jwcxz/CEREBRO/src/latex/code.pdf

## Appendix A: Cerebro Code, Main File, Joseph Colosimo

; vim : t s=4 sw=4 fdm=marker ;−−−−−−−−−−−−−−−−−−−−−−−−−−−−−−−−−−−−−−−−−−−−−−−−−−−−−−−−−−−−−−−−−−−−−−−−−−−−−−−

; C E R E B R O
; J . Colosimo
; 6. 1 1 5 Fi n al P r o j e c t ;
; CEREBRO
; main f i l e
;−−−−−−−−−−−−−−−−−−−−−−−−−−−−−−−−−−−−−−−−−−−−−−−−−−−−−−−−−−−−−−−−−−−−−−−−−−−−−−−

;−−−−−−−−−−−−−−−−−−−−−−−−−−−−−−−−−−−−−−−−−−−−−−−−−−−−−−−−−−−−−−−−−−−−−−−−−−−−−−−

; CONSTANTS
;−−−−−−−−−−−−−−−−−−−−−−−−−−−−−−−−−−−−−−−−−−−−−−−−−−−−−−−−−−−−−−−−−−−−−−−−−−−−−−−

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

+23=0x4F
Vm eeg thta equ Vm eeg dl ta+03d | ; | t h e t a
Vm ee g l alp equ Vm eeg dl ta+06d | ; | low alph a
Vm eeg halp equ Vm eeg dl ta+09d | ; | hi gh alph a
Vm ee g lbe t equ Vm eeg dl ta+012d | ; | low be t a
Vm eeg hbet equ Vm eeg dl ta+015d | ; | hi gh be t a
Vm eeg lgam equ Vm eeg dl ta+018d | ; | low gamma
Vm eeg mgam equ Vm eeg dl ta+021d | ; | mid gamma
Vm eeg csum got equ 070h | ; r e c e i v e d checksum ( f o r debugging )
Vm e e g a t t n l s t equ 07Dh | ; p r e vi o u s a t t e n t i o n v al u e
Vm eeg md tn ls t equ 07Eh | ; p r e vi o u s m e di t a ti o n v al u e

; e q u a l i z e r board c o n t ai n e r memory
Vm eqb vals equ 0B0h | ; 0xB0 −> 0xB7

; LED p a n el output b u f f e r ( used by F l p s e t p i x e l s )
Vm led r gb a r g s equ 071h | ; 0 x71 −> 0 x71+12=0x7C
Vm led rgba rg0 equ ( Vm led r gb a r g s ) | ; p i x e l 0
Vm led rgba rg1 equ ( Vm led r gb a r g s +3) | ; p i x e l 1
Vm led rgba rg2 equ ( Vm led r gb a r g s +6) | ; p i x e l 2
Vm led rgba rg3 equ ( Vm led r gb a r g s +9) | ; p i x e l 3

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

; ewma v al u e s
Vm ewma p0hue equ 0C0h
Vm ewma p0val equ ( Vm ewma p0hue+1) Vm ewma p1hue equ ( Vm ewma p0hue+2) Vm ewma p1val equ ( Vm ewma p0hue+3) Vm ewma p2hue equ ( Vm ewma p0hue+4) Vm ewma p2val equ ( Vm ewma p0hue+5) Vm ewma p3hue equ ( Vm ewma p0hue+6) Vm ewma p3val equ ( Vm ewma p0hue+7) ; }}}

o r g 00h
l jmp main

;−−−−−−−−−−−−−−−−−−−−−−−−−−−−−−−−−−−−−−−−−−−−−−−−−−−−−−−−−−−−−−−−−−−−−−−−−−−−−−−

; INTERRUPTS
;−−−−−−−−−−−−−−−−−−−−−−−−−−−−−−−−−−−−−−−−−−−−−−−−−−−−−−−−−−−−−−−−−−−−−−−−−−−−−−− 2

o r g 03h
l jmp F e c i n t

o r g 0Bh
l jmp F t h i n t

;−−−−−−−−−−−−−−−−−−−−−−−−−−−−−−−−−−−−−−−−−−−−−−−−−−−−−−−−−−−−−−−−−−−−−−−−−−−−−−−

; MAIN LOOP
;−−−−−−−−−−−−−−−−−−−−−−−−−−−−−−−−−−−−−−−−−−−−−−−−−−−−−−−−−−−−−−−−−−−−−−−−−−−−−−−

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

; s e t data ready o f f
mov R0 , #Vm eeg drdy
mov @R0, #00h

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

mov R0 , #Vm led rgbargsA
mov R1 , #012d
L m ai n i ni tA b u f :
mov @R0, #0h
i n c R0
d jnz R1 , L m ai n i ni tA b u f

mov R0 , #Vm led rgbargsB
mov R1 , #012d
L m ai n i ni tB b u f :
mov @R0, #0h
i n c R0
d jnz R1 , L m ai n i ni tB b u f

mov R0 , #Vm ewma p0hue
mov R1 , #08d
3

L main ini tewmabu f :
mov @R0, #0h
i n c R0
d jnz R1 , L main ini tewmabu f

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

; c o n v e r t the sec ond v al u e t o something between 1 and 4 f o r the ; t r a n s i t i o n speed
mov R0 , #Vm eqb vals+1
mov A, @R0
mov B, #064d
di v AB
i n c A | ; A r a n g e s from 1 − 4
i n c A | ; A r a n g e s from 2 − 5
i n c A | ; A r a n g e s from 3 − 6
mov @R0, A

; c o n v e r t the 3 rd v al u e t o something between 0 and f o r the al g o ; s e l e c t i o n
mov R0 , #Vm eqb vals+2
mov A, @R0
mov B, #064d
di v AB
mov @R0, A

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

mov R0 , #Vm eeg attn
mov A, @R0
mov R0 , #Vm e e g a t t n l s t mov @R0, A
4

mov R0 , #Vm eeg mdtn
mov A, @R0
mov R0 , #Vm eeg md tn ls t mov @R0, A
;−−−−−−

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

sjmp L m ain l o op

;−−−−−−−−−−−−−−−−−−−−−−−−−−−−−−−−−−−−−−−−−−−−−−−−−−−−−−−−−−−−−−−−−−−−−−−−−−−−−−−

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

mov A, #’ ’
l c a l l F s c t x

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

mov A, #’ ’
l c a l l F s c t x

mov R0 , #Vm eeg mdtn ; m e di t a ti o n mov A, @R0
l c a l l F s c p r t h e x

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

l c a l l F s c c r l f

5

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

r e t
; }}}

;−−−−−−−−−−−−−−−−−−−−−−−−−−−−−−−−−−−−−−−−−−−−−−−−−−−−−−−−−−−−−−−−−−−−−−−−−−−−−−−

; INCLUDES
;−−−−−−−−−−−−−−−−−−−−−−−−−−−−−−−−−−−−−−−−−−−−−−−−−−−−−−−−−−−−−−−−−−−−−−−−−−−−−−−

#i n cl u d e e e g c t r l . asm

#i n cl u d e eqboard . asm

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

6

## Appendix A: Cerebro Code, EEG Controller Library, Joseph Colosimo

; vim : t s=4 sw=4 fdm=marker ;−−−−−−−−−−−−−−−−−−−−−−−−−−−−−−−−−−−−−−−−−−−−−−−−−−−−−−−−−−−−−−−−−−−−−−−−−−−−−−−

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

;−−−−−−−−−−−−−−−−−−−−−−−−−−−−−−−−−−−−−−−−−−−−−−−−−−−−−−−−−−−−−−−−−−−−−−−−−−−−−−−

; NEEDED VALUES
;−−−−−−−−−−−−−−−−−−−−−−−−−−−−−−−−−−−−−−−−−−−−−−−−−−−−−−−−−−−−−−−−−−−−−−−−−−−−−−−

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

;−−−−−−−−−−−−−−−−−−−−−−−−−−−−−−−−−−−−−−−−−−−−−−−−−−−−−−−−−−−−−−−−−−−−−−−−−−−−−−−

; CONSTANTS
;−−−−−−−−−−−−−−−−−−−−−−−−−−−−−−−−−−−−−−−−−−−−−−−−−−−−−−−−−−−−−−−−−−−−−−−−−−−−−−−

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

V e c v al s y n c equ 0AAh

;−−−−−−−−−−−−−−−−−−−−−−−−−−−−−−−−−−−−−−−−−−−−−−−−−−−−−−−−−−−−−−−−−−−−−−−−−−−−−−−

; FUNCTIONS
;−−−−−−−−−−−−−−−−−−−−−−−−−−−−−−−−−−−−−−−−−−−−−−−−−−−−−−−−−−−−−−−−−−−−−−−−−−−−−−−
F e c i n t : | ; i n t e r r u p t h a n dl e r {{{ | 7

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

; s a ve A, B, and r e g i s t e r s {{{
push acc
push B
push DPH
push DPL
push 00h | ; R0
push 01h | ; R1
push 02h | ; R2
push 03h | ; R3
push 04h | ; R4
; }}}

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

mov R1 , #Vm eeg plen
mov A, @R1
mov R2 , A

mov R1 , #Vm eeg csum
mov A, @R1
mov R3 , A

mov R1 , #Vm eeg pptr
mov A, @R1
mov R4 , A
; }}}

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

mov A, R1 ; s a ve p acke t l e n g t h
add A, #01h
mov R2 , A

9

; new s t a t e −> payld
mov R0 , #V e c s t p a yl d

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

d jnz R2 , F e c i n t u s p a y l d s a v e

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

F e c i n t u s p a y l d s a v e :
mov B, R1 | ; B <− R1
mov A, R4
mov R1 , A | ; R1 = R4
mov @R1, B | ; s a ve c u r r e n t by te
mov R1 , B | ; R1 <− B
i n c R4 | ; inc remen t p oi n t e r
mov A, R3
add A, R1 | ; add t o checksum
mov R3 , A

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

; check t o s e e t h a t we have a v a l i d checksum
mov A, R3
c pl A
mov R3 , A ; s a ve checksum back

; FIXME: f o r debugging
; mov R3 , A ; s a ve checksum back ; mov R0 , #Vm eeg csum got
; mov B, R1
; mov @R0, B

; new s t a t e −> sync1
10 mov R0 , #V e c s t s y n c 1

; hack : u se R1 = 01h
c j n e A, 01h , F e c i n t u s c h k sm b a d

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

l jmp F e c i n t u s d o n e

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

l jmp F e c i n t u s d o n e

F e c i n t u s d o n e :

F e c i n t e n d :
; s e t memory v al u e s {{{ mov R1 , #Vm eeg smst
mov A, R0
mov @R1, A

mov R1 , #Vm eeg plen
mov A, R2
mov @R1, A

mov R1 , #Vm eeg csum
mov A, R3
mov @R1, A

mov R1 , #Vm eeg pptr
mov A, R4
mov @R1, A
; }}}

; r e s t o r e A, B, and r e g i s t e r s {{{ pop 04h ; R4
pop 03h ; R3
pop 02h ; R2
pop 01h ; R1
pop 00h ; R0
pop DPL
11

pop DPH
pop B
pop acc
; }}}

r e t i
; }}}

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

; s e t d i v i s o r
; 1. 8 4 2 e6 /16/9600 ˜= 12 mov A, #0Ch
mov DPTR, #V a e e g d l l movx @DPTR, A
mov A, #000h
mov DPTR, #Va eeg dlm
movx @DPTR, A

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

r e t
; }}}

F e c pl d : ; p r o c e s s payload {{{ ; −−− a c c o u n ti n g −−−
12

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

; s a ve A, B, and r e g i s t e r s {{{ push acc
push B
push 00h | ; R0
push 01h | ; R1
push 02h | ; R2
; }}}

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

F e c pl d d o n e :
; r e s t o r e A, B, and r e g i s t e r s {{{ pop 02h ; R2
pop 01h ; R1
pop 00h ; R0
pop B
13

pop acc
; }}}

r e t
; }}}

14

## Appendix A: Cerebro Code, Equalizer Board Library, Joseph Colosimo

; vim : t s=4 sw=4 fdm=marker ;−−−−−−−−−−−−−−−−−−−−−−−−−−−−−−−−−−−−−−−−−−−−−−−−−−−−−−−−−−−−−−−−−−−−−−−−−−−−−−−

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

;−−−−−−−−−−−−−−−−−−−−−−−−−−−−−−−−−−−−−−−−−−−−−−−−−−−−−−−−−−−−−−−−−−−−−−−−−−−−−−−

; NEEDED VALUES
;−−−−−−−−−−−−−−−−−−−−−−−−−−−−−−−−−−−−−−−−−−−−−−−−−−−−−−−−−−−−−−−−−−−−−−−−−−−−−−−

; Va eqb mux , Va eqb adc , Vm eqb val

;−−−−−−−−−−−−−−−−−−−−−−−−−−−−−−−−−−−−−−−−−−−−−−−−−−−−−−−−−−−−−−−−−−−−−−−−−−−−−−−

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

d jnz R1 , F e q s c a n l o o p

F e q s c a n d o n e :
; r e s t o r e A, B, and r e g i s t e r s {{{ pop 02h ; R2
pop 01h ; R1
pop 00h ; R0
pop DPL
pop DPH
pop B
pop acc
; }}}

r e t
; }}}

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

16

## Appendix A: Cerebro Code, Signal Processing Library, Joseph Colosimo

; vim : t s=4 sw=4 fdm=marker ;−−−−−−−−−−−−−−−−−−−−−−−−−−−−−−−−−−−−−−−−−−−−−−−−−−−−−−−−−−−−−−−−−−−−−−−−−−−−−−−

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

;−−−−−−−−−−−−−−−−−−−−−−−−−−−−−−−−−−−−−−−−−−−−−−−−−−−−−−−−−−−−−−−−−−−−−−−−−−−−−−−

; NEEDED VALUES
;−−−−−−−−−−−−−−−−−−−−−−−−−−−−−−−−−−−−−−−−−−−−−−−−−−−−−−−−−−−−−−−−−−−−−−−−−−−−−−−

; Vm eeg sgnl , Vm eeg dlta , Vm eeg attn , Vm eeg mdtn
; Vm led a r gbu f

;−−−−−−−−−−−−−−−−−−−−−−−−−−−−−−−−−−−−−−−−−−−−−−−−−−−−−−−−−−−−−−−−−−−−−−−−−−−−−−−

; CONSTANTS
;−−−−−−−−−−−−−−−−−−−−−−−−−−−−−−−−−−−−−−−−−−−−−−−−−−−−−−−−−−−−−−−−−−−−−−−−−−−−−−−

;−−−−−−−−−−−−−−−−−−−−−−−−−−−−−−−−−−−−−−−−−−−−−−−−−−−−−−−−−−−−−−−−−−−−−−−−−−−−−−−

; FUNCTIONS
;−−−−−−−−−−−−−−−−−−−−−−−−−−−−−−−−−−−−−−−−−−−−−−−−−−−−−−−−−−−−−−−−−−−−−−−−−−−−−−−

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

; s a ve A, B, and r e g i s t e r s {{{ push acc
push B
push 00h | ; R0
push 01h | ; R1
push 02h | ; R2
push 03h | ; R3
push 04h | ; R4 | 17

push 05h | ; R5
push 06h | ; R6
push 07h | ; R7
; }}}

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

mov R0 , #Vm eeg sgnl
mov A, @R0
j z F s p p r o c e s s s i g o k a y

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

F s p p r o c e s s d o n e :
; r e s t o r e A, B, and r e g i s t e r s {{{ pop 07h ; R7
pop 06h ; R6
pop 05h ; R5
pop 04h ; R4
pop 03h ; R3
pop 02h ; R2
pop 01h ; R1
pop 00h ; R0
pop B
pop acc
; }}}

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

; R1 : rgb p oi n t e r
; R2 : c o u n t e r

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

mov R0 , #Vm eeg sgnl
mov A, @R0
j z F s p si g b a d s e n s o k a y e n d
mov R0 , A

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

mov R0 , #Vm led a r gbu f
mov @R0, #030h
mov R0 , #Vm led a r gbu f+3 mov @R0, #030h
mov R0 , #Vm led a r gbu f+6 mov @R0, #030h
mov R0 , #Vm led a r gbu f+9 mov @R0, #030h
r e t

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

mov R2 , B ; temp
mov B, A
c l r C
mov A, #04d
subb A, B | ; 4 − q u o ti e n t g i v e s s i g n a l q u a l i t y low −> hi gh
mov R1 , A | ; temp

mov B, R2
mov A, #020d
c l r C
subb A, B ; 20 − rem ainde r g i v e s s i g q u a l i t y rem ainde r mov B, #04d
mul AB | ; s c a l e up
mov B, A | ; B has rem ainde r 0−>79
mov A, R1 | ; A has q u o ti e n t | 0−>4
| | 19

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

F s p si g o k a y d o n e :
r e t
; }}}

F s p al g o 1 : ; {{{
mov R0 , #Vm eeg sgnl
mov A, @R0
j n z F s p al g o 1 d o n e

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

mov A, R3
| 21

mov R0 , A | ; r e s t o r e R0
l c a l l F cu h s v 2 r gb | ; HSV −> RGB
mov A, R0
mov R3 , A | ; R3 <− R0

mov A, R3
mov R0 , #Vm led a r gbu f 0 mov @R0, A
mov R0 , #Vm led a r gbu f 1 mov @R0, A

mov A, R1
mov R0 , #Vm led a r gbu f 0+1 mov @R0, A
mov R0 , #Vm led a r gbu f 1+1 mov @R0, A

mov A, R2
mov R0 , #Vm led a r gbu f 0+2 mov @R0, A
mov R0 , #Vm led a r gbu f 1+2
mov @R0, A
;−−−−−−−−−−−−−−−−−−−−−−−−−−−−−−−−−−− }}}

; s e t m e di t a ti o n c o l o r {{{
; s e t m e di t a ti o n hue
; we want i t t o vary from cyan −> pu rple , which i s about 0+128−>85+128 mov B, #085d ; 120/360 x255 = 85
mov R0 , #Vm eeg mdtn
mov A, @R0
add A, #080h ; add
mov R3 , A
; s e t m e di t a ti o n s a t u r a t i o n mov R1 , #0FFh
; s e t m e di t a ti o n v al u e
mov R0 , #Vm eeg mdtn
mov A, @R0
mov R0 , #Vm eeg md tn ls t mov B, @R0
c l r C
subb A, B
jnb OV, F s p si g o k a y s ki pm d t n c pl c pl A
i n c A
F s p si g o k a y s ki pm d t n c pl :
mov B, #04d
mul AB
mov R2 , A

mov A, R3
mov R0 , A | ; r e s t o r e R0
l c a l l F cu h s v 2 r gb | ; HSV −> RGB
mov A, R0
mov R3 , A | ; R3 <− R0
22

mov A, R3
mov R0 , #Vm led a r gbu f 2 mov @R0, A
mov R0 , #Vm led a r gbu f 3 mov @R0, A

mov A, R1
mov R0 , #Vm led a r gbu f 2+1 mov @R0, A
mov R0 , #Vm led a r gbu f 3+1 mov @R0, A

mov A, R2
mov R0 , #Vm led a r gbu f 2+2 mov @R0, A
mov R0 , #Vm led a r gbu f 3+2
mov @R0, A
;−−−−−−−−−−−−−−−−−−−−−−−−−−−−−−−−−−− }}}

F s p al g o 1 d o n e :
r e t
; }}}

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

mov A, R0 ; s e t red
mov R0 , #Vm led a r gbu f 0 mov @R0, A
mov A, R1 ; s e t g r e en i n c R0
mov @R0, A
mov A, R2 ; s e t bl u e
i n c R0
mov @R0, A
; −−−

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

mov A, R0 ; s e t red
mov R0 , #Vm led a r gbu f 1 mov @R0, A
mov A, R1 ; s e t g r e en i n c R0
mov @R0, A
mov A, R2 ; s e t bl u e
i n c R0
mov @R0, A
; −−−

; p i x e l 2
mov R1 , #0FFh | ; f u l l s a t u r a t i o n
mov R0 , #Vm ee g lbe t+1 | ; 2nd by te o f low be t a
mov A, @R0
c l r C
r r c A
mov R2 , A
mov R0 , #0128d | ; bl u e
l c a l l F cu h s v 2 r gb

mov A, R0 ; s e t red
mov R0 , #Vm led a r gbu f 2 mov @R0, A
mov A, R1 ; s e t g r e en i n c R0
mov @R0, A
mov A, R2 ; s e t bl u e
i n c R0
mov @R0, A
; −−−

; p i x e l 3
mov R1 , #0FFh | ; f u l l s a t u r a t i o n
mov R0 , #Vm eeg lgam+1 | ; 2nd by te o f low gamma
mov A, @R0
c l r C
r r c A
mov R2 , A
mov R0 , #0196d | ; p u r pl e
l c a l l F cu h s v 2 r gb

mov A, R0 ; s e t red
mov R0 , #Vm led a r gbu f 3 mov @R0, A
mov A, R1 ; s e t g r e en i n c R0
mov @R0, A
mov A, R2 ; s e t bl u e
i n c R0
mov @R0, A
; −−−
24

F s p al g o 2 d o n e :
r e t
; }}}

F s p al g o 3 :
; p i x e l 0 {{{
; hue
mov R0 , #Vm eeg dl ta ; ! mov A, @R0
mov R1 , A
mov R0 , #Vm eeg thta+1 ; !
mov A, @R0
c l r C
subb A, R1 | ; l o w f r e q − hi g h f r e q
j c F s p al g o 3 p 0m o r el f t ; ! i f l o w f r e q > hi g h f r e q , s h i f t hue l e f t
F s p al g o 3 p 0m o r e r g t : | ; !
mov R7 , #042d | ; !
l jmp F s p al g o 3 p 0 h u e ; !
F s p al g o 3 p 0m o r el f t : | ; !
mov R7 , #0d | ; !
l jmp F s p al g o 3 p 0 h u e ; !
F s p al g o 3 p 0 h u e : | ; !
mov R1 , #Vm eqb vals+3
mov B, @R1 | ; B = ewma
mov A, #0FFh
c l r C
subb A, B | ; A = 1−ewma
mov R0 , #Vm ewma p0hue | ; !
mov B, @R0 | ; B = oldhue
mul AB
mov R3 , B | ; R3 = (1−ewma) ∗ oldhue
mov B, @R1 | ; B = ewma
mov A, R7 | ; R7 i s newhue
mul AB | ; B = (ewma) ∗newhue
mov A, R3
add A, B
mov R3 , A | ; R3 = ewma∗newhue + (1−ewma) ∗ oldhue

; v al u e
V s p al g o 3 p 0 v al : | ; !
mov R1 , #Vm eqb vals+4
mov B, @R1 | ; B = ewma
mov A, #0FFh
c l r C
subb A, B | ; A = 1−ewma
mov R0 , #Vm ewma p0val | ; !
mov B, @R0 | ; B = ol d v al
mul AB
25

mov R4 , B | ; R4 = (1−ewma) ∗ ol d v al
mov R0 , #Vm eeg dl ta | ; !
mov A, @R0
c l r C
r r c A
mov B, A
mov R0 , #Vm eeg thta+1 ; ! mov A, @R0
c l r C
r r c A
add A, B | ; A = newval ( a v e r a g e )
mov B, @R1 | ; B = ewma
mul AB
mov A, R4
add A, B
mov R4 , A | ; R4 = ewma∗newval + (1−ewma) ∗ ol d v al

; update ol d v al u e s
mov R0 , #Vm ewma p0hue | ; !
mov A, R3
mov @R0, A
mov R0 , #Vm ewma p0val | ; !
mov A, R4
mov @R0, A

; s e t e v e r y t hi n g mov A, R3
mov R0 , A
mov R1 , #0FFh
mov A, R4
mov R2 , A

l c a l l F cu h s v 2 r gb

mov A, R0 | ; s e t red
mov R0 , #Vm led a r gbu f 0 | ; !
mov @R0, A
mov A, R1 ; s e t g r e en
i n c R0
mov @R0, A
mov A, R2 ; s e t bl u e
i n c R0
mov @R0, A
; }}}

; p i x e l 1 {{{
; hue
mov R0 , #Vm ee g l alp+1 ; ! mov A, @R0
mov R1 , A
mov R0 , #Vm eeg halp+1 ; ! mov A, @R0
c l r C
26

subb A, R1 | ; l o w f r e q − hi g h f r e q
j c F s p al g o 3 p 1m o r el f t ; ! i f l o w f r e q > hi g h f r e q , s h i f t hue l e f t
F s p al g o 3 p 1m o r e r g t : | ; !
mov R7 , #084d | ; !
l jmp F s p al g o 3 p 1 h u e ; !
F s p al g o 3 p 1m o r el f t : | ; !
mov R7 , #042d | ; !
l jmp F s p al g o 3 p 1 h u e ; !
F s p al g o 3 p 1 h u e : | ; !
mov R1 , #Vm eqb vals+3
mov B, @R1 | ; B = ewma
mov A, #0FFh
c l r C
subb A, B | ; A = 1−ewma
mov R0 , #Vm ewma p1hue | ; !
mov B, @R0 | ; B = oldhue
mul AB
mov R3 , B | ; R3 = (1−ewma) ∗ oldhue
mov B, @R1 | ; B = ewma
mov A, R7 | ; R7 i s newhue
mul AB | ; B = (ewma) ∗newhue
mov A, R3
add A, B
mov R3 , A | ; R3 = ewma∗newhue + (1−ewma) ∗ oldhue

; v al u e
V s p al g o 3 p 1 v al : | ; !
mov R1 , #Vm eqb vals+5 | ; !
mov B, @R1 | ; B = ewma
mov A, #0FFh
c l r C
subb A, B | ; A = 1−ewma
mov R0 , #Vm ewma p1val | ; !
mov B, @R0 | ; B = ol d v al
mul AB
mov R4 , B | ; R4 = (1−ewma) ∗ ol d v al
mov R0 , #Vm ee g l alp+1 | ; !
mov A, @R0
c l r C
r r c A
mov B, A
mov R0 , #Vm eeg halp+1 ; ! mov A, @R0
c l r C
r r c A
add A, B | ; A = newval ( a v e r a g e )
mov B, @R1 | ; B = ewma
mul AB
mov A, R4
27

add A, B
mov R4 , A | ; R4 = ewma∗newval + (1−ewma) ∗ ol d v al

; update ol d v al u e s
mov R0 , #Vm ewma p1hue | ; !
mov A, R3
mov @R0, A
mov R0 , #Vm ewma p1val | ; !
mov A, R4
mov @R0, A

; s e t e v e r y t hi n g mov A, R3
mov R0 , A
mov R1 , #0FFh
mov A, R4
mov R2 , A

l c a l l F cu h s v 2 r gb

mov A, R0 | ; s e t red
mov R0 , #Vm led a r gbu f 1 | ; !
mov @R0, A
mov A, R1 ; s e t g r e en
i n c R0
mov @R0, A
mov A, R2 ; s e t bl u e
i n c R0
mov @R0, A
; }}}

; p i x e l 2 {{{
; hue
mov R0 , #Vm ee g lbe t+1 ; ! mov A, @R0
mov R1 , A
mov R0 , #Vm eeg hbet+1 ; !
mov A, @R0
c l r C
subb A, R1 | ; l o w f r e q − hi g h f r e q
j c F s p al g o 3 p 2m o r el f t ; ! i f l o w f r e q > hi g h f r e q , s h i f t hue l e f t
F s p al g o 3 p 2m o r e r g t : | ; !
mov R7 , #0126d | ; !
l jmp F s p al g o 3 p 2 h u e ; !
F s p al g o 3 p 2m o r el f t : | ; !
mov R7 , #084d | ; !
l jmp F s p al g o 3 p 2 h u e ; !
F s p al g o 3 p 2 h u e : | ; !
mov R1 , #Vm eqb vals+3
mov B, @R1 | ; B = ewma
mov A, #0FFh
c l r C
28

subb A, B | ; A = 1−ewma
mov R0 , #Vm ewma p2hue | ; !
mov B, @R0 | ; B = oldhue
mul AB
mov R3 , B | ; R3 = (1−ewma) ∗ oldhue
mov B, @R1 | ; B = ewma
mov A, R7 | ; R7 i s newhue
mul AB | ; B = (ewma) ∗newhue
mov A, R3
add A, B
mov R3 , A | ; R3 = ewma∗newhue + (1−ewma) ∗ oldhue

; v al u e
V s p al g o 3 p 2 v al : | ; !
mov R1 , #Vm eqb vals+6 | ; !
mov B, @R1 | ; B = ewma
mov A, #0FFh
c l r C
subb A, B | ; A = 1−ewma
mov R0 , #Vm ewma p2val | ; !
mov B, @R0 | ; B = ol d v al
mul AB
mov R4 , B | ; R4 = (1−ewma) ∗ ol d v al
mov R0 , #Vm ee g lbe t+1 | ; !
mov A, @R0
c l r C
r r c A
mov B, A
mov R0 , #Vm eeg hbet+1 ; ! mov A, @R0
c l r C
r r c A
add A, B | ; A = newval ( a v e r a g e )
mov B, @R1 | ; B = ewma
mul AB
mov A, R4
add A, B
mov R4 , A | ; R4 = ewma∗newval + (1−ewma) ∗ ol d v al

; update ol d v al u e s
mov R0 , #Vm ewma p2hue | ; !
mov A, R3
mov @R0, A
mov R0 , #Vm ewma p2val | ; !
mov A, R4
mov @R0, A

; s e t e v e r y t hi n g mov A, R3
mov R0 , A
mov R1 , #0FFh
29

mov A, R4
mov R2 , A

l c a l l F cu h s v 2 r gb

mov A, R0 | ; s e t red
mov R0 , #Vm led a r gbu f 2 | ; !
mov @R0, A
mov A, R1 ; s e t g r e en
i n c R0
mov @R0, A
mov A, R2 ; s e t bl u e
i n c R0
mov @R0, A
; }}}

; p i x e l 3 {{{
; hue
mov R0 , #Vm eeg lgam+1 ; ! mov @R0, A
mov R1 , A
mov R0 , #Vm eeg mgam+1 ; ! mov @R0, A
c l r C
r l c A
c l r C
subb A, R1 | ; l o w f r e q − hi g h f r e q
j c F s p al g o 3 p 3m o r el f t ; ! i f l o w f r e q > hi g h f r e q , s h i f t hue l e f t
F s p al g o 3 p 3m o r e r g t : | ; !
mov R7 , #0168d | ; !
l jmp F s p al g o 3 p 3 h u e ; !
F s p al g o 3 p 3m o r el f t : | ; !
mov R7 , #0126d | ; !
l jmp F s p al g o 3 p 3 h u e ; !
F s p al g o 3 p 3 h u e : | ; !
mov R1 , #Vm eqb vals+3
mov B, @R1 | ; B = ewma
mov A, #0FFh
c l r C
subb A, B | ; A = 1−ewma
mov R0 , #Vm ewma p3hue | ; !
mov B, @R0 | ; B = oldhue
mul AB
mov R3 , B | ; R3 = (1−ewma) ∗ oldhue
mov A, B
mov B, @R1 | ; B = ewma
mov A, R7 | ; R7 i s newhue
mul AB | ; B = (ewma) ∗newhue
mov A, R3
add A, B
30

mov R3 , A | ; R3 = ewma∗newhue + (1−ewma) ∗ oldhue

; v al u e
V s p al g o 3 p 3 v al : | ; !
mov R1 , #Vm eqb vals+7 | ; !
mov B, @R1 | ; B = ewma
mov A, #0FFh
c l r C
subb A, B | ; A = 1−ewma
mov R0 , #Vm ewma p3val | ; !
mov B, @R0 | ; B = ol d v al
mul AB
mov R4 , B | ; R4 = (1−ewma) ∗ ol d v al
mov R0 , #Vm eeg lgam+1 | ; !
mov A, @R0
c l r C
r r c A
mov B, A
mov R0 , #Vm eeg mgam+1 ; ! mov A, @R0
c l r C
r r c A
add A, B | ; A = newval ( a v e r a g e )
mov B, @R1 | ; B = ewma
mul AB
mov A, R4
add A, B
mov R4 , A | ; R4 = ewma∗newval + (1−ewma) ∗ ol d v al

; update ol d v al u e s
mov R0 , #Vm ewma p3hue | ; !
mov A, R3
mov @R0, A
mov R0 , #Vm ewma p3val | ; !
mov A, R4
mov @R0, A

; s e t e v e r y t hi n g mov A, R3
mov R0 , A
mov R1 , #0FFh
mov A, R4
mov R2 , A

l c a l l F cu h s v 2 r gb

mov A, R0 | ; s e t red
mov R0 , #Vm led a r gbu f 3 | ; !
mov @R0, A
mov A, R1 ; s e t g r e en
i n c R0
mov @R0, A
31

mov A, R2 ; s e t bl u e
i n c R0
mov @R0, A
; }}}

F s p al g o 3 d o n e :
r e t

32

## Appendix A: Cerebro Code, Transition Library, Joseph Colosimo

; vim : t s=4 sw=4 fdm=marker ;−−−−−−−−−−−−−−−−−−−−−−−−−−−−−−−−−−−−−−−−−−−−−−−−−−−−−−−−−−−−−−−−−−−−−−−−−−−−−−−

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

;−−−−−−−−−−−−−−−−−−−−−−−−−−−−−−−−−−−−−−−−−−−−−−−−−−−−−−−−−−−−−−−−−−−−−−−−−−−−−−−

; CONSTANTS
;−−−−−−−−−−−−−−−−−−−−−−−−−−−−−−−−−−−−−−−−−−−−−−−−−−−−−−−−−−−−−−−−−−−−−−−−−−−−−−−

;−−−−−−−−−−−−−−−−−−−−−−−−−−−−−−−−−−−−−−−−−−−−−−−−−−−−−−−−−−−−−−−−−−−−−−−−−−−−−−−

; FUNCTIONS
;−−−−−−−−−−−−−−−−−−−−−−−−−−−−−−−−−−−−−−−−−−−−−−−−−−−−−−−−−−−−−−−−−−−−−−−−−−−−−−−

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

; s a ve A, B, and r e g i s t e r s {{{ push acc
push B
push 00h | ; R0
push 01h | ; R1
push 02h | ; R2
; }}}

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

F t h c o p y s e tA :
mov @R0, #Vm led rgbargsA
l jmp F t h c o p y d o

F t h c o p y s e tB :
mov @R0, #Vm led rgbargsB
l jmp F t h c o p y d o

F t h c o p y d o :
mov A, @R0 | 33

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

F th c op y d one :
; r e s t o r e A, B, and r e g i s t e r s {{{ pop 02h ; R2
pop 01h ; R1
pop 00h ; R0
pop B
pop acc
; }}}

r e t
; }}}

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

; r e s e t c r o s s f a d e
mov R0 , #Vm led x fade
mov @R0, #0h

; e n a bl e tim e r
s e t b TR0

; r e s t o r e r e g i s t e r s {{{ pop 00h ; R0
; }}}

r e t
; }}}

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

; s a ve A, B, and r e g i s t e r s {{{ push acc
push B
34

push 00h | ; R0
push 01h | ; R1
push 02h | ; R2
push 03h | ; R3
push 04h | ; R4
push 05h | ; R5
push 06h | ; R6
; }}}

; g e t some v al u e s from memory mov R0 , #Vm led x fade
mov A, @R0
mov R3 , A

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

F t h i n t d o :
mov R2 , #Vm led r gb a r g s mov R4 , #012d
F t h i n t d o l o o p :
mov A, #0FFh
c l r C
subb A, R3
mov B, A | ; B = 255−x f a d e
mov A, @R0 | ; A = s t a r t v al u e
mul AB | ; A∗B
mov R5 , B | ; R5 h ol d s r e s u l t
mov A, @R1 | ; A = end v al u e
mov B, R3 | ; B = x f a d e
mul AB | ; A∗B
mov A, B | ; A h ol d s r e s u l t
add A, R5 | ; sum the two v al u e s
mov B, A | ; s t o r e t o B
mov A, R2 | ; A has output p oi n t e r
xch A, R0 | ; R0 now has output p oi n t e r
; A has s t a r t p oi n t e r
mov @R0, B | ; s t o r e output
xch A, R0 | ; A has output p oi n t e r
; R0 has s t a r t p oi n t e r mov R2 , A ; R2 has output p oi n t e r

35

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

d jnz R4 , F t h i n t d o l o o p

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

F t h i n t d o n e s k i p s t o p :
; r e s t o r e A, B, and r e g i s t e r s {{{
pop 06h ; R6
pop 05h ; R5
pop 04h ; R4
pop 03h ; R3
pop 02h ; R2
pop 01h ; R1
pop 00h ; R0
pop B
pop acc
; }}}

r e t i
; }}}

F t h i n i t t i m e r :
mov TMOD, #022h
mov TH0, #0128d
s e t b ET0
r e t

36

## Appendix A: Cerebro Code, LED Panel Controller Library, Joseph Colosimo

; vim : t s=4 sw=4 fdm=marker ;−−−−−−−−−−−−−−−−−−−−−−−−−−−−−−−−−−−−−−−−−−−−−−−−−−−−−−−−−−−−−−−−−−−−−−−−−−−−−−−

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

;−−−−−−−−−−−−−−−−−−−−−−−−−−−−−−−−−−−−−−−−−−−−−−−−−−−−−−−−−−−−−−−−−−−−−−−−−−−−−−−

; NEEDED VALUES
;−−−−−−−−−−−−−−−−−−−−−−−−−−−−−−−−−−−−−−−−−−−−−−−−−−−−−−−−−−−−−−−−−−−−−−−−−−−−−−−

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

;−−−−−−−−−−−−−−−−−−−−−−−−−−−−−−−−−−−−−−−−−−−−−−−−−−−−−−−−−−−−−−−−−−−−−−−−−−−−−−−

; CONSTANTS
;−−−−−−−−−−−−−−−−−−−−−−−−−−−−−−−−−−−−−−−−−−−−−−−−−−−−−−−−−−−−−−−−−−−−−−−−−−−−−−−

V l p l p i d equ 05h

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

;−−−−−−−−−−−−−−−−−−−−−−−−−−−−−−−−−−−−−−−−−−−−−−−−−−−−−−−−−−−−−−−−−−−−−−−−−−−−−−−

; FUNCTIONS
;−−−−−−−−−−−−−−−−−−−−−−−−−−−−−−−−−−−−−−−−−−−−−−−−−−−−−−−−−−−−−−−−−−−−−−−−−−−−−−−
F l p s e t w h ol e p a n el : | ; s e t a l l 4 p i x e l s t o same c o l o r {{{
; a r g s : R0 : red , R1 : grn , R2 : blu
; −−− a c c o u n ti n g −−− {{{
; R0 : red
; R1 : grn
; R2 : blu
; }}}

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

37

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

mov A, R0
l c a l l F l p s e n d b y t e | ; red

mov A, R1
l c a l l F l p s e n d b y t e | ; g re e n

mov A, R2
l c a l l F l p s e n d b y t e | ; bl u e

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

; s a ve A, B, and r e g i s t e r s {{{ push acc
push 00h | ; R0
push 01h | ; R1
push 02h | ; R2
; }}}

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

mov R1 , #Vm eqb vals
mov A, @R1
mov R1 , A

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

mov B, R1 ; apply g ai n c o r r e c t i o n mul AB
38

mov A, B

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

; s e t d i v i s o r
; 1. 8 4 3 2 e6 /16/38400 = 3 mov A, #03h
mov DPTR, #V a l e d d l l movx @DPTR, A
mov A, #000h
mov DPTR, #Va led dlm
movx @DPTR, A

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

pop acc
r e t
; }}}
F l p s e n d b y t e : | ; send a by te t o the LED Panel UART {{{
; a r g s : A: byte
; send by te t o 16C450
39

push 0h ; R0
push DPH
push DPL

mov DPTR, #V a l e d t h r movx @DPTR, A

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

pop DPL
pop DPH
pop 0h ; R0
r e t
; }}}

40

## Appendix A: Cerebro Code, Serial Communication Library, Joseph Colosimo

; vim : t s=4 sw=4 fdm=marker ;−−−−−−−−−−−−−−−−−−−−−−−−−−−−−−−−−−−−−−−−−−−−−−−−−−−−−−−−−−−−−−−−−−−−−−−−−−−−−−−

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

;−−−−−−−−−−−−−−−−−−−−−−−−−−−−−−−−−−−−−−−−−−−−−−−−−−−−−−−−−−−−−−−−−−−−−−−−−−−−−−−

; FUNCTIONS
;−−−−−−−−−−−−−−−−−−−−−−−−−−−−−−−−−−−−−−−−−−−−−−−−−−−−−−−−−−−−−−−−−−−−−−−−−−−−−−−
F s c i n i t s e r i a l : | ; i n i t i a l i z e s e r i a l communication {{{
mov TMOD, #020h | ; sw−c o n t r o l l e d gate , tim e r mode , 8−b i t a r time r 1
s e t b TR1
; mov | TH1, #0FFh | ; TH1 = 256 − 2 x11 . 0 5 9 2 e6 /384/57600 = 255 with PCON
on
; o r l | PCON, #080h | ; s e t PCON on
mov TH1, #0FDh
mov | SCON, #050h | ; e n a bl e 8−b i t UART, REN on

r e t
; }}}

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

42

## Appendix A: Cerebro Code, Color Utilities, Joseph Colosimo

; vim : t s=4 sw=4 fdm=marker ;−−−−−−−−−−−−−−−−−−−−−−−−−−−−−−−−−−−−−−−−−−−−−−−−−−−−−−−−−−−−−−−−−−−−−−−−−−−−−−−

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

;−−−−−−−−−−−−−−−−−−−−−−−−−−−−−−−−−−−−−−−−−−−−−−−−−−−−−−−−−−−−−−−−−−−−−−−−−−−−−−−

; CONSTANTS
;−−−−−−−−−−−−−−−−−−−−−−−−−−−−−−−−−−−−−−−−−−−−−−−−−−−−−−−−−−−−−−−−−−−−−−−−−−−−−−−

;−−−−−−−−−−−−−−−−−−−−−−−−−−−−−−−−−−−−−−−−−−−−−−−−−−−−−−−−−−−−−−−−−−−−−−−−−−−−−−−

; FUNCTIONS
;−−−−−−−−−−−−−−−−−−−−−−−−−−−−−−−−−−−−−−−−−−−−−−−−−−−−−−−−−−−−−−−−−−−−−−−−−−−−−−−

F cu h s v 2 r gb : ; c o n v e r t s hsv v al u e s i n t o rgb {{{
; a r g s : R0 : hue , R1 : s a t , R2 : v al
; out : R0 : red , R1 : grn , R2 : blu
; −−− a c c o u n ti n g −−− {{{
; R0 : hue −> red
; R1 : s a t −> grn
; R2 : v al −> blu
;
; R3 : h∗
; R4 : f
; R5 : p
; R6 : q
; R7 : t
; }}}

; s a ve A, B, and r e g i s t e r s {{{ push acc
push B
push 03h | ; R3
push 04h | ; R4
push 05h | ; R5
push 06h | ; R6
push 07h | ; R7
; }}}

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

; f i r s t , we want h∗ , the hex hue chunk o f a v al u e
; | 60 / ( 3 6 0 / 2 5 5 ) = 4 2. 5 , s o each hex a g on al hue chunk i s r o u g hl y sp aced
; | 4 2. 5 v a l s away . okay , s o that ’ s a b i t annoying , but we can make some
; | sp aced a t 42 and o t h e r s a t 43 a s f o l l o w s :
; | | | 42 | | | 43 | | | 42 | | | 43 | | | 42 | | | 43 | |
; | | | 0 | | | 1 | | | 2 | | | 3 | | | 4 | | | 5 | |
; | | | 0 : 4 1 | 4 2: 8 4 | 8 5 : 1 2 6 | 1 2 7 : 1 6 9 | 1 7 0 : 2 1 1 | 2 1 2 : 2 5 5 |

mov A, R0
mov B, #042d
di v AB

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

; nex t compute p = v ∗ ( 1 − s )
mov A, #0FFh
c l r C
subb A, R1 | ; A = 255 − s
mov B, R2 | ; B = v al
mul AB | ; p = v al ∗ ( 2 5 5 − s )
mov R5 , B | ; p = top byte ( r an ge s h i f t 256∗256 −> 2 5 6 )

; and q = v ∗ ( 1 − f ∗ s )
mov A, R4 | ; A = f
mov B, R1 | ; B = s
mul AB | ; compute f ∗ s | ( r an ge 0−>255∗41)
;−−−−−−−−−−−−− TODO: s u b r o u ti n e−i f y
; now we need a r an ge s h i f t from 0−>255∗41 t o 0−>255
; we do t h i s by m ul ti pl yi n g the v al u e by 255/42 = 6 and t a ki n g the top
| byte
push 00h ; R0
push 01h ; R1
mov R0 , B | ; s a ve hi gh by te o f m u l t i p l i c a t i o n
mov B, #06d
mul AB | ; m ul ti pl y low byte
44

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

pop 01h ; R1
pop 00h ; R0
;−−−−−−−−−−−−−
mov B, A | ; move q u o ti e n t t o B
mov A, #0FFh
c l r C
subb A, B | ; A = 255 − f ∗ s
mov B, R2 | ; B = v al
mul AB | ; q = v al ∗ ( 2 5 5 − f ∗ s )
mov R6 , B | ; q = top byte

; and f i n a l l y t = v ∗ ( 1 − ( 1 − f ) ∗ s ) mov A, #042d
c l r C
subb A, R4 | ; A = 42 − f
mov B, R1 | ; B = s a t
mul AB | ; AB = (42− f ) ∗ s
;−−−−−−−−−−−−− TODO: s u b r o u ti n e−i f y
; now we need a r an ge s h i f t from 0−>255∗41 t o 0−>255
; we do t h i s by m ul ti pl yi n g the v al u e by 255/42 = 6 and t a ki n g the top byte
push 00h ; R0
push 01h ; R1
mov R0 , B | ; s a ve hi gh by te o f m u l t i p l i c a t i o n
mov B, #06d
mul AB | ; m ul ti pl y low byte
mov R1 , B | ; we onl y c a r e about hi gh by te o f t h a t r e s u l t
mov A, R0
mov B, #06d
mul AB | ; m ul ti pl y p r e vi o u s hi gh byte by 6
add A, R1 | ; add low by te o f the r e s u l t t o the hi gh byte o f the
p r e vi o u s r e s u l t

pop 01h ; R1
pop 00h ; R0
;−−−−−−−−−−−−−
mov B, A | ; move q u o ti e n t t o B
mov A, #0FFh
c l r C
subb A, B | ; A = 255 − (42− f ) ∗ s
mov B, R2 | ; B = v al
mul AB | ; t = v al ∗ ( 2 5 5 − (42− f ) ∗ s )
mov R7 , B | ; t = top byte

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

c j n e R3 , #00h , F c u h s v 2 r g b h 1
mov A, R2 | ; v
mov R0 , A
mov A, R7 | ; t
mov R1 , A
mov A, R5 | ; p
mov R2 , A
l jmp F c u h s v 2 r g b e n d
F c u h s v 2 r g b h 1 : | ; rgb = qvp
c j n e R3 , #01h , F c u h s v 2 r g b h 2
mov A, R6 | ; q
mov R0 , A
mov A, R2 | ; v
mov R1 , A
mov A, R5 | ; p
mov R2 , A
l jmp F c u h s v 2 r g b e n d
F c u h s v 2 r g b h 2 : | ; rgb = pvt
c j n e R3 , #02h , F c u h s v 2 r g b h 3
mov A, R5 | ; p
mov R0 , A
mov A, R2 | ; v
mov R1 , A
mov A, R7 | ; t
mov R2 , A
l jmp F c u h s v 2 r g b e n d
F c u h s v 2 r g b h 3 : | ; rgb = pqv
c j n e R3 , #03h , F c u h s v 2 r g b h 4
mov A, R5 | ; p
mov R0 , A
mov A, R6 | ; q
mov R1 , A
mov A, R2 | ; v
mov R2 , A
l jmp F c u h s v 2 r g b e n d
F c u h s v 2 r g b h 4 : | ; rgb = tpv
c j n e R3 , #04h , F c u h s v 2 r g b h 5
mov A, R7 | ; t
mov R0 , A
mov A, R5 | ; p
mov R1 , A
mov A, R2 | ; v
mov R2 , A
l jmp F c u h s v 2 r g b e n d
F c u h s v 2 r g b h 5 : | ; rgb = vpq
mov A, R2 | ; v
mov R0 , A
mov A, R5 | ; p
mov R1 , A
46

mov A, R6 | ; q
mov R2 , A
l jmp F c u h s v 2 r g b e n d

F c u h s v 2 r g b e n d :
; r e s t o r e A, B, and r e g i s t e r s {{{
pop 07h | ; R7
pop 06h | ; R6
pop 05h | ; R5
pop 04h | ; R4
pop 03h | ; R3
pop B
pop acc
; }}}

r e t
; }}}

47

## Appendix A: Cerebro Code, EEG Data Capture Utility, Joseph Colosimo

;−−−−−−−−−−−−−−−−−−−−−−−−−−−−−−−−−−−−−−−−−−−−−−−−−−−−−−−−−−−−−−−−−−−−−−−−−−−−−−−

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

;−−−−−−−−−−−−−−−−−−−−−−−−−−−−−−−−−−−−−−−−−−−−−−−−−−−−−−−−−−−−−−−−−−−−−−−−−−−−−−−

; CONSTANTS
;−−−−−−−−−−−−−−−−−−−−−−−−−−−−−−−−−−−−−−−−−−−−−−−−−−−−−−−−−−−−−−−−−−−−−−−−−−−−−−−

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

;−−−−−−−−−−−−−−−−−−−−−−−−−−−−−−−−−−−−−−−−−−−−−−−−−−−−−−−−−−−−−−−−−−−−−−−−−−−−−−−

; INCLUDES
;−−−−−−−−−−−−−−−−−−−−−−−−−−−−−−−−−−−−−−−−−−−−−−−−−−−−−−−−−−−−−−−−−−−−−−−−−−−−−−−

o r g 00h
l jmp main

;−−−−−−−−−−−−−−−−−−−−−−−−−−−−−−−−−−−−−−−−−−−−−−−−−−−−−−−−−−−−−−−−−−−−−−−−−−−−−−−

; INTERRUPTS
;−−−−−−−−−−−−−−−−−−−−−−−−−−−−−−−−−−−−−−−−−−−−−−−−−−−−−−−−−−−−−−−−−−−−−−−−−−−−−−−

;−−−−−−−−−−−−−−−−−−−−−−−−−−−−−−−−−−−−−−−−−−−−−−−−−−−−−−−−−−−−−−−−−−−−−−−−−−−−−−−

; MAIN LOOP
;−−−−−−−−−−−−−−−−−−−−−−−−−−−−−−−−−−−−−−−−−−−−−−−−−−−−−−−−−−−−−−−−−−−−−−−−−−−−−−−

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

; t e s t
48

; Lloop :
; | mov A, #’T’
; | l c a l l F s e r t x
; | sjmp Lloop

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

sjmp L m ain l o op

;−−−−−−−−−−−−−−−−−−−−−−−−−−−−−−−−−−−−−−−−−−−−−−−−−−−−−−−−−−−−−−−−−−−−−−−−−−−−−−−

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

; s e t d i v i s o r
; 1. 8 4 2 e6 /16/9600 ˜= 12 mov A, #0Ch
mov DPTR, #V a d d r e e g dll movx @DPTR, A
mov A, #000h
mov DPTR, #V add r ee g dlm movx @DPTR, A

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

; s e t b EX0
; s e t b EA
49

r e t
; }}}
F i n i t s e r i a l : | ; i n i t i a l i z e s e r i a l communication {{{
mov TMOD, #020h | ; sw−c o n t r o l l e d gate , tim e r mode , 8−b i t a r time r 1
s e t b TR1
; mov | TH1, #0FFh | ; TH1 = 256 − 2 x11 . 0 5 9 2 e6 /384/57600 = 255 with PCON
on
; o r l | PCON, #080h | ; s e t PCON on
mov TH1, #0FDh
mov | SCON, #050h | ; e n a bl e 8−b i t UART, REN on

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

; −−− −−− −−−
; vim : e t t s=4 sw=4 fdm=marker

50

## Appendix A: Cerebro Code, Payload Test, Joseph Colosimo

; vim : t s=4 sw=4 fdm=marker ;−−−−−−−−−−−−−−−−−−−−−−−−−−−−−−−−−−−−−−−−−−−−−−−−−−−−−−−−−−−−−−−−−−−−−−−−−−−−−−−

; C E R E B R O
; J . Colosimo
; 6. 1 1 5 Fi n al P r o j e c t
;
; EEG Payload Capture Test
; Gets payload , d oe s b a si c p r o c e s si n g , p r i n t s t o s e r i a l ;−−−−−−−−−−−−−−−−−−−−−−−−−−−−−−−−−−−−−−−−−−−−−−−−−−−−−−−−−−−−−−−−−−−−−−−−−−−−−−−

;−−−−−−−−−−−−−−−−−−−−−−−−−−−−−−−−−−−−−−−−−−−−−−−−−−−−−−−−−−−−−−−−−−−−−−−−−−−−−−−

; CONSTANTS
;−−−−−−−−−−−−−−−−−−−−−−−−−−−−−−−−−−−−−−−−−−−−−−−−−−−−−−−−−−−−−−−−−−−−−−−−−−−−−−−

Va eeg equ 0FE00h
V a ee g r xb equ ( Va eeg + 00h ) | ; r e c e i v e r b u f f e r r e g ( dl ab = 0 )
V a e e g i e r equ ( Va eeg + 01h ) | ; i n t e r r u p t e n a bl e r e g ( dl ab = 0 )
V a e e g d l l equ ( Va eeg + 00h ) | ; d i v i s o r l a t c h ( l s b ) ( dl ab = 1 )
Va eeg dlm equ ( Va eeg + 01h ) | ; d i v i s o r l a t c h (msb ) ( dl ab = 1 )
V a e e g l c r equ ( Va eeg + 03h ) | ; l i n e c o n t r o l r e g
V a e e g l s r equ ( Va eeg + 05h ) | ; l i n e s t a t u s r e g
Vm eeg pptr d equ 050h | ; 0 x50 −> 0 x50+32=0x6F
Vm eeg smst | equ 030h
Vm eeg plen | equ 031h
Vm eeg pptr | equ 032h
Vm eeg csum | equ 033h
Vm eeg sgnl | equ 034h
Vm eeg dl ta | equ 038h | ; 0 x38 −> 0 x38+23=0x4F
Vm eeg attn | equ 035h
Vm eeg mdtn | equ 036h
Vm eeg drdy | equ 037h
Vm eeg csum got equ 072h
; Vm ee g ip t r | equ 070h
; Vm eeg optr | equ 071h

o r g 00h
l jmp main

;−−−−−−−−−−−−−−−−−−−−−−−−−−−−−−−−−−−−−−−−−−−−−−−−−−−−−−−−−−−−−−−−−−−−−−−−−−−−−−−

; INTERRUPTS
;−−−−−−−−−−−−−−−−−−−−−−−−−−−−−−−−−−−−−−−−−−−−−−−−−−−−−−−−−−−−−−−−−−−−−−−−−−−−−−−

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

; | push dph
; | push dpl
; | push 00h ; R0
;
; | mov R0 , #Vm ee g ip t r
; | mov A, @R0 | ; g e t i p t r
; | mov R0 , A | ; R0 <− i p t r
;
; | mov DPTR, #V a ee g r xb
; | movx A, @DPTR | ; g e t by te from s e r i a l
;
; | mov @R0, A | ; s t o r e byte t o @ip t r
;
; | i n c R0 | ; inc remen t p oi n t e r
; | c j n e R0 , #Vm eeg bu f+064d , IE0 end | ; i f we h i t the end o f the b u f f e r . . .
; | mov R0 , #Vm eeg bu f ; then wrap
;
; | IE0 end :
; | mov A, R0
; | mov R0 , #Vm ee g ip t r
; | mov @R0, A
; | pop 00h ; R0
; | pop dpl
; | pop dph
; | pop acc
;
; | r e t i

;−−−−−−−−−−−−−−−−−−−−−−−−−−−−−−−−−−−−−−−−−−−−−−−−−−−−−−−−−−−−−−−−−−−−−−−−−−−−−−−

; MAIN LOOP
;−−−−−−−−−−−−−−−−−−−−−−−−−−−−−−−−−−−−−−−−−−−−−−−−−−−−−−−−−−−−−−−−−−−−−−−−−−−−−−−

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

mov R0 , #Vm eeg drdy
mov @R0, #00h

L m ain l o op :
mov R0 , #Vm eeg drdy
mov A, @R0
j z L m ain l o op ; i s v al u e ready ?

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

mov A, #’ ’
l c a l l F s c t x

mov R0 , #Vm eeg mdtn ; m e di t a ti o n mov A, @R0
l c a l l F s c p r t h e x

mov A, #’ ’
l c a l l F s c t x

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

l c a l l F s c c r l f

; r e s e t drdy
mov R0 , #Vm eeg drdy
mov @R0, #00h

sjmp L m ain l o op

;−−−−−−−−−−−−−−−−−−−−−−−−−−−−−−−−−−−−−−−−−−−−−−−−−−−−−−−−−−−−−−−−−−−−−−−−−−−−−−−

; FUNCTIONS
;−−−−−−−−−−−−−−−−−−−−−−−−−−−−−−−−−−−−−−−−−−−−−−−−−−−−−−−−−−−−−−−−−−−−−−−−−−−−−−−

;−−−−−−−−−−−−−−−−−−−−−−−−−−−−−−−−−−−−−−−−−−−−−−−−−−−−−−−−−−−−−−−−−−−−−−−−−−−−−−−

; INCLUDES
;−−−−−−−−−−−−−−−−−−−−−−−−−−−−−−−−−−−−−−−−−−−−−−−−−−−−−−−−−−−−−−−−−−−−−−−−−−−−−−−

#i n cl u d e e e g c t r l . asm

#i n cl u d e sercom . asm

53

## Appendix A: Cerebro Code, LED Panel Test 1, Joseph Colosimo

; vim : t s=4 sw=4 fdm=marker ;−−−−−−−−−−−−−−−−−−−−−−−−−−−−−−−−−−−−−−−−−−−−−−−−−−−−−−−−−−−−−−−−−−−−−−−−−−−−−−−

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

;−−−−−−−−−−−−−−−−−−−−−−−−−−−−−−−−−−−−−−−−−−−−−−−−−−−−−−−−−−−−−−−−−−−−−−−−−−−−−−−

; CONSTANTS
;−−−−−−−−−−−−−−−−−−−−−−−−−−−−−−−−−−−−−−−−−−−−−−−−−−−−−−−−−−−−−−−−−−−−−−−−−−−−−−−

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

;−−−−−−−−−−−−−−−−−−−−−−−−−−−−−−−−−−−−−−−−−−−−−−−−−−−−−−−−−−−−−−−−−−−−−−−−−−−−−−−

; INCLUDES
;−−−−−−−−−−−−−−−−−−−−−−−−−−−−−−−−−−−−−−−−−−−−−−−−−−−−−−−−−−−−−−−−−−−−−−−−−−−−−−−

o r g 00h
l jmp main

;−−−−−−−−−−−−−−−−−−−−−−−−−−−−−−−−−−−−−−−−−−−−−−−−−−−−−−−−−−−−−−−−−−−−−−−−−−−−−−−

; INTERRUPTS
;−−−−−−−−−−−−−−−−−−−−−−−−−−−−−−−−−−−−−−−−−−−−−−−−−−−−−−−−−−−−−−−−−−−−−−−−−−−−−−−

;−−−−−−−−−−−−−−−−−−−−−−−−−−−−−−−−−−−−−−−−−−−−−−−−−−−−−−−−−−−−−−−−−−−−−−−−−−−−−−−

; MAIN LOOP
;−−−−−−−−−−−−−−−−−−−−−−−−−−−−−−−−−−−−−−−−−−−−−−−−−−−−−−−−−−−−−−−−−−−−−−−−−−−−−−−

o r g 0100h
main :
l c a l l F i n i t l e d

L m ain l o op :
mov DPTR, #V a d d r l e d t h r

54

mov A, #0aah
movx @DPTR, A

Lwait0 :
movx A, @DPTR
j n z A, Lwait0

mov A, #0252d
movx @DPTR, A

Lwait1 :
movx A, @DPTR
j n z A, Lwait1

mov A, #080d
movx @DPTR, A

Lwait2 :
movx A, @DPTR
j n z A, Lwait2

mov A, #010d
movx @DPTR, A

Lwait3 :
movx A, @DPTR
j n z A, Lwait3

mov A, #040d
movx @DPTR, A

mov R0 , #0h
mov R1 , #0h
LwaitA :
LwaitB :
; d jnz R0 , LwaitB
d jnz R1 , LwaitA

sjmp L m ain l o op

;−−−−−−−−−−−−−−−−−−−−−−−−−−−−−−−−−−−−−−−−−−−−−−−−−−−−−−−−−−−−−−−−−−−−−−−−−−−−−−−

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

55

; s e t d i v i s o r
; 1. 8 4 3 2 e6 /16/38400 = 3 mov A, #03h
mov DPTR, #V a d d r l e d d l l movx @DPTR, A
mov A, #000h
mov DPTR, #V add r led dlm movx @DPTR, A

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

r e t
; }}}

; −−− −−− −−−
; vim : e t t s=4 sw=4 fdm=marker

56

## Appendix A: Cerebro Code, LED Panel Test 2, Joseph Colosimo

; vim : t s=4 sw=4 fdm=marker ;−−−−−−−−−−−−−−−−−−−−−−−−−−−−−−−−−−−−−−−−−−−−−−−−−−−−−−−−−−−−−−−−−−−−−−−−−−−−−−−

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

;−−−−−−−−−−−−−−−−−−−−−−−−−−−−−−−−−−−−−−−−−−−−−−−−−−−−−−−−−−−−−−−−−−−−−−−−−−−−−−−

; CONSTANTS
;−−−−−−−−−−−−−−−−−−−−−−−−−−−−−−−−−−−−−−−−−−−−−−−−−−−−−−−−−−−−−−−−−−−−−−−−−−−−−−−

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

;−−−−−−−−−−−−−−−−−−−−−−−−−−−−−−−−−−−−−−−−−−−−−−−−−−−−−−−−−−−−−−−−−−−−−−−−−−−−−−−

; INCLUDES
;−−−−−−−−−−−−−−−−−−−−−−−−−−−−−−−−−−−−−−−−−−−−−−−−−−−−−−−−−−−−−−−−−−−−−−−−−−−−−−−

o r g 00h
l jmp main

;−−−−−−−−−−−−−−−−−−−−−−−−−−−−−−−−−−−−−−−−−−−−−−−−−−−−−−−−−−−−−−−−−−−−−−−−−−−−−−−

; INTERRUPTS
;−−−−−−−−−−−−−−−−−−−−−−−−−−−−−−−−−−−−−−−−−−−−−−−−−−−−−−−−−−−−−−−−−−−−−−−−−−−−−−−

;−−−−−−−−−−−−−−−−−−−−−−−−−−−−−−−−−−−−−−−−−−−−−−−−−−−−−−−−−−−−−−−−−−−−−−−−−−−−−−−

; MAIN LOOP
;−−−−−−−−−−−−−−−−−−−−−−−−−−−−−−−−−−−−−−−−−−−−−−−−−−−−−−−−−−−−−−−−−−−−−−−−−−−−−−− 57

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

L m ain l o op :
mov DPTR, #V a d d r l e d t h r mov A, #’a ’
movx @DPTR, A

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

; pause
Lwait1 :
Lwait2 :
; d jnz R0 , Lwait2
d jnz R1 , Lwait1

sjmp L m ain l o op

;−−−−−−−−−−−−−−−−−−−−−−−−−−−−−−−−−−−−−−−−−−−−−−−−−−−−−−−−−−−−−−−−−−−−−−−−−−−−−−−

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

; s e t d i v i s o r
; 2 e6 /16/38400 ˜= 3 , but with a 7% e r r o r r a t e −− maybe t o o hi gh ; mov A, #03h
mov A, #03h
mov DPTR, #V a d d r l e d d l l
movx @DPTR, A
mov A, #000h
mov DPTR, #V add r led dlm movx @DPTR, A

58

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

; s e t d i v i s o r
; 2 e6 /16/9600 ˜= 13
mov A, #03h
mov DPTR, #V a d d r e e g dll movx @DPTR, A
mov A, #000h
mov DPTR, #V add r ee g dlm movx @DPTR, A

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

; s e t b EX0
; s e t b EA

r e t
; }}}
F i n i t s e r i a l : | ; i n i t i a l i z e s e r i a l communication {{{
mov TMOD, #020h | ; sw−c o n t r o l l e d gate , tim e r mode , 8−b i t a r time r 1
s e t b TR1
; mov | TH1, #0FFh | ; TH1 = 256 − 2 x11 . 0 5 9 2 e6 /384/57600 = 255 with PCON
on
| | 59

; o r l | PCON, #080h | ; s e t PCON on
mov TH1, #0FDh
mov | SCON, #050h | ; e n a bl e 8−b i t UART, REN on

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

; −−− −−− −−−
; vim : e t t s=4 sw=4 fdm=marker

60

## Appendix A: Cerebro Code, LED Panel Test 3, Joseph Colosimo

; vim : t s=4 sw=4 fdm=marker ;−−−−−−−−−−−−−−−−−−−−−−−−−−−−−−−−−−−−−−−−−−−−−−−−−−−−−−−−−−−−−−−−−−−−−−−−−−−−−−−

; C E R E B R O
; J . Colosimo
; 6. 1 1 5 Fi n al P r o j e c t
;
; LED Panel C ol o r S h i f t i n g Test
; shows a hue s h i f t i n g output on the LED p a n el ;−−−−−−−−−−−−−−−−−−−−−−−−−−−−−−−−−−−−−−−−−−−−−−−−−−−−−−−−−−−−−−−−−−−−−−−−−−−−−−−

;−−−−−−−−−−−−−−−−−−−−−−−−−−−−−−−−−−−−−−−−−−−−−−−−−−−−−−−−−−−−−−−−−−−−−−−−−−−−−−−

; CONSTANTS
;−−−−−−−−−−−−−−−−−−−−−−−−−−−−−−−−−−−−−−−−−−−−−−−−−−−−−−−−−−−−−−−−−−−−−−−−−−−−−−−

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

o r g 00h
l jmp main

;−−−−−−−−−−−−−−−−−−−−−−−−−−−−−−−−−−−−−−−−−−−−−−−−−−−−−−−−−−−−−−−−−−−−−−−−−−−−−−−

; INTERRUPTS
;−−−−−−−−−−−−−−−−−−−−−−−−−−−−−−−−−−−−−−−−−−−−−−−−−−−−−−−−−−−−−−−−−−−−−−−−−−−−−−−

;−−−−−−−−−−−−−−−−−−−−−−−−−−−−−−−−−−−−−−−−−−−−−−−−−−−−−−−−−−−−−−−−−−−−−−−−−−−−−−−

; MAIN LOOP
;−−−−−−−−−−−−−−−−−−−−−−−−−−−−−−−−−−−−−−−−−−−−−−−−−−−−−−−−−−−−−−−−−−−−−−−−−−−−−−−

o r g 0100h
main :
l c a l l F l p i n i t l e d

mov R3 , #020h
mov R4 , #0FFh
mov R5 , #030h

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

61

; mov A, #0252d
; l c a l l F l p s e n d b y t e

; mov A, #080d
; l c a l l F l p s e n d b y t e

; mov A, #010d
; l c a l l F l p s e n d b y t e

; mov A, #040d
; l c a l l F l p s e n d b y t e ; }}}

mov A, R3
mov R0 , A

mov A, R4
mov R1 , A

mov A, R5
mov R2 , A

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

; mov A, R3
; add A, #05h
; mov R3 , A
i n c R3

; −− pause and l o o p −−
mov R6 , #0h
mov R7 , #0h
LwaitA :
LwaitB :
; d jnz R6 , LwaitB
d jnz R7 , LwaitA

l jmp L m ain l o op

;−−−−−−−−−−−−−−−−−−−−−−−−−−−−−−−−−−−−−−−−−−−−−−−−−−−−−−−−−−−−−−−−−−−−−−−−−−−−−−−

; FUNCTIONS
;−−−−−−−−−−−−−−−−−−−−−−−−−−−−−−−−−−−−−−−−−−−−−−−−−−−−−−−−−−−−−−−−−−−−−−−−−−−−−−−

;−−−−−−−−−−−−−−−−−−−−−−−−−−−−−−−−−−−−−−−−−−−−−−−−−−−−−−−−−−−−−−−−−−−−−−−−−−−−−−−

; INCLUDES
;−−−−−−−−−−−−−−−−−−−−−−−−−−−−−−−−−−−−−−−−−−−−−−−−−−−−−−−−−−−−−−−−−−−−−−−−−−−−−−−

#i n cl u d e c o l u t i l s . asm

#i n cl u d e l e d p a n el . asm

62

; −−− −−− −−−
; vim : e t t s=4 sw=4 fdm=marker

63

## Appendix A: Cerebro Code, Equalizer Board Test, Joseph Colosimo

; vim : t s=4 sw=4 fdm=marker ;−−−−−−−−−−−−−−−−−−−−−−−−−−−−−−−−−−−−−−−−−−−−−−−−−−−−−−−−−−−−−−−−−−−−−−−−−−−−−−−

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

;−−−−−−−−−−−−−−−−−−−−−−−−−−−−−−−−−−−−−−−−−−−−−−−−−−−−−−−−−−−−−−−−−−−−−−−−−−−−−−−

; CONSTANTS
;−−−−−−−−−−−−−−−−−−−−−−−−−−−−−−−−−−−−−−−−−−−−−−−−−−−−−−−−−−−−−−−−−−−−−−−−−−−−−−−

Va eqb mux equ P1
Va eqb adc equ 0FE10h

o r g 00h
l jmp main

;−−−−−−−−−−−−−−−−−−−−−−−−−−−−−−−−−−−−−−−−−−−−−−−−−−−−−−−−−−−−−−−−−−−−−−−−−−−−−−−

; MAIN LOOP
;−−−−−−−−−−−−−−−−−−−−−−−−−−−−−−−−−−−−−−−−−−−−−−−−−−−−−−−−−−−−−−−−−−−−−−−−−−−−−−−

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

l c a l l F s c p r t h e x

mov A, #’ ’
l c a l l F s c t x

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

l c a l l F s c c r l f
mov R0 , #0d
L w ai t : d jnz R0 , L w ai t mov R0 , #0d
L w ai t 2 : d jnz R0 , L w ai t 2
sjmp L m ain l o op

;−−−−−−−−−−−−−−−−−−−−−−−−−−−−−−−−−−−−−−−−−−−−−−−−−−−−−−−−−−−−−−−−−−−−−−−−−−−−−−−

; INCLUDES
;−−−−−−−−−−−−−−−−−−−−−−−−−−−−−−−−−−−−−−−−−−−−−−−−−−−−−−−−−−−−−−−−−−−−−−−−−−−−−−−

#i n cl u d e sercom . asm

65
