jwcxz/CEREBRO/proposal/fig/blockdiagram.pdf

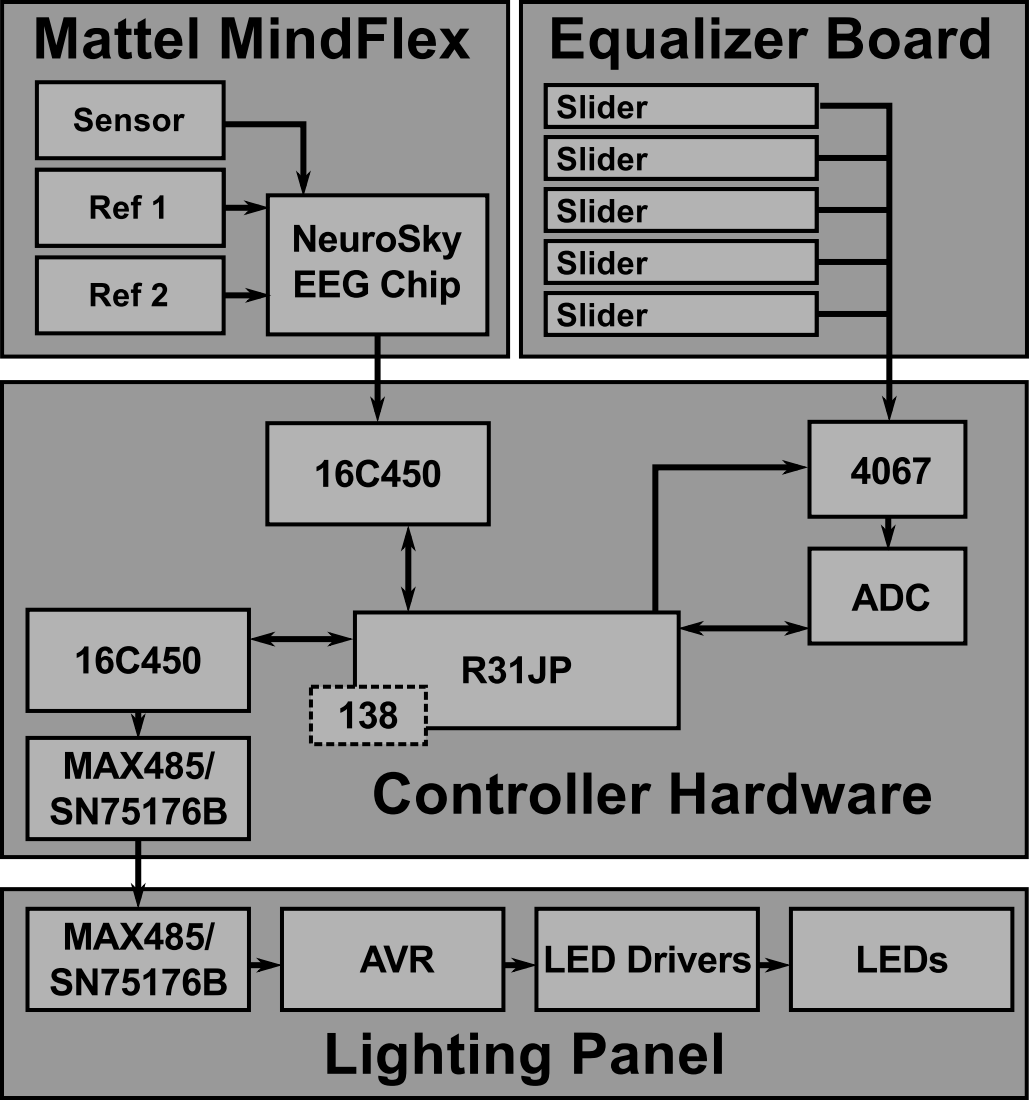
[picture p11: page 1]
