jwcxz/CEREBRO/proposal/fig/drawing.pdf

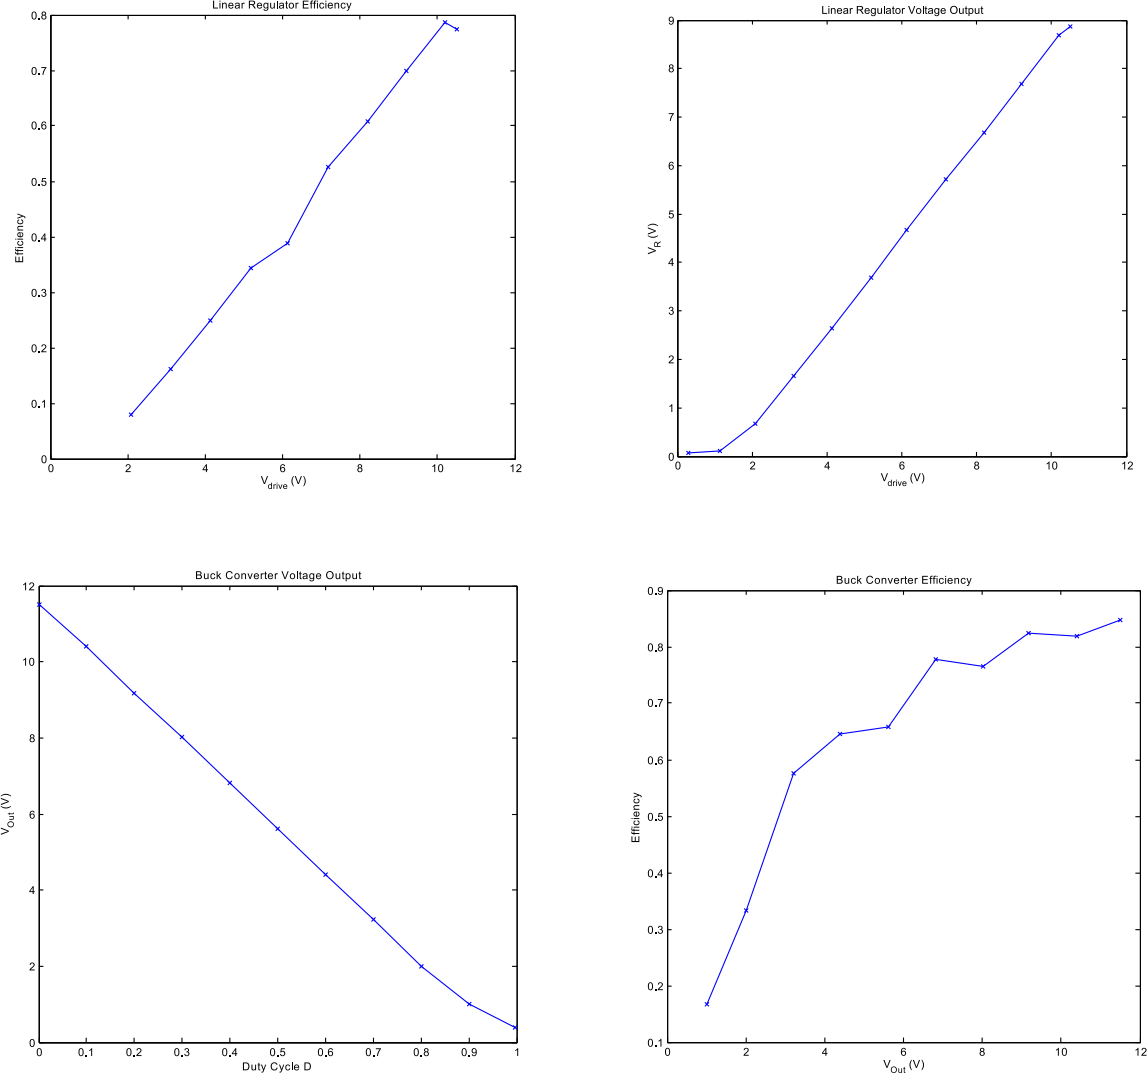
[picture p13: page 1]
