jwcxz/CEREBRO/proposal/fig/software.pdf

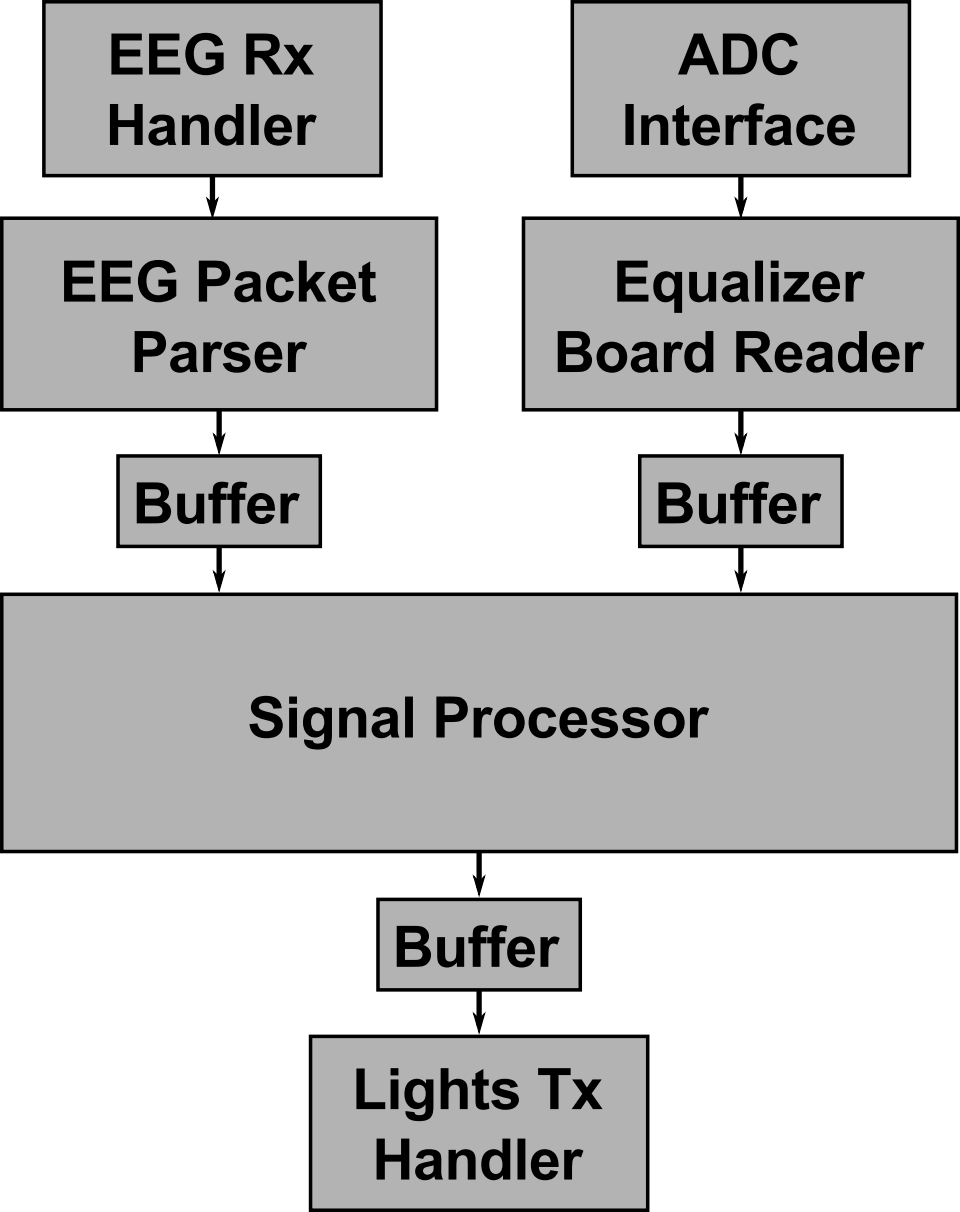
[picture p14: page 1]
