jwcxz/CEREBRO/report/fig/blockdiagram.pdf

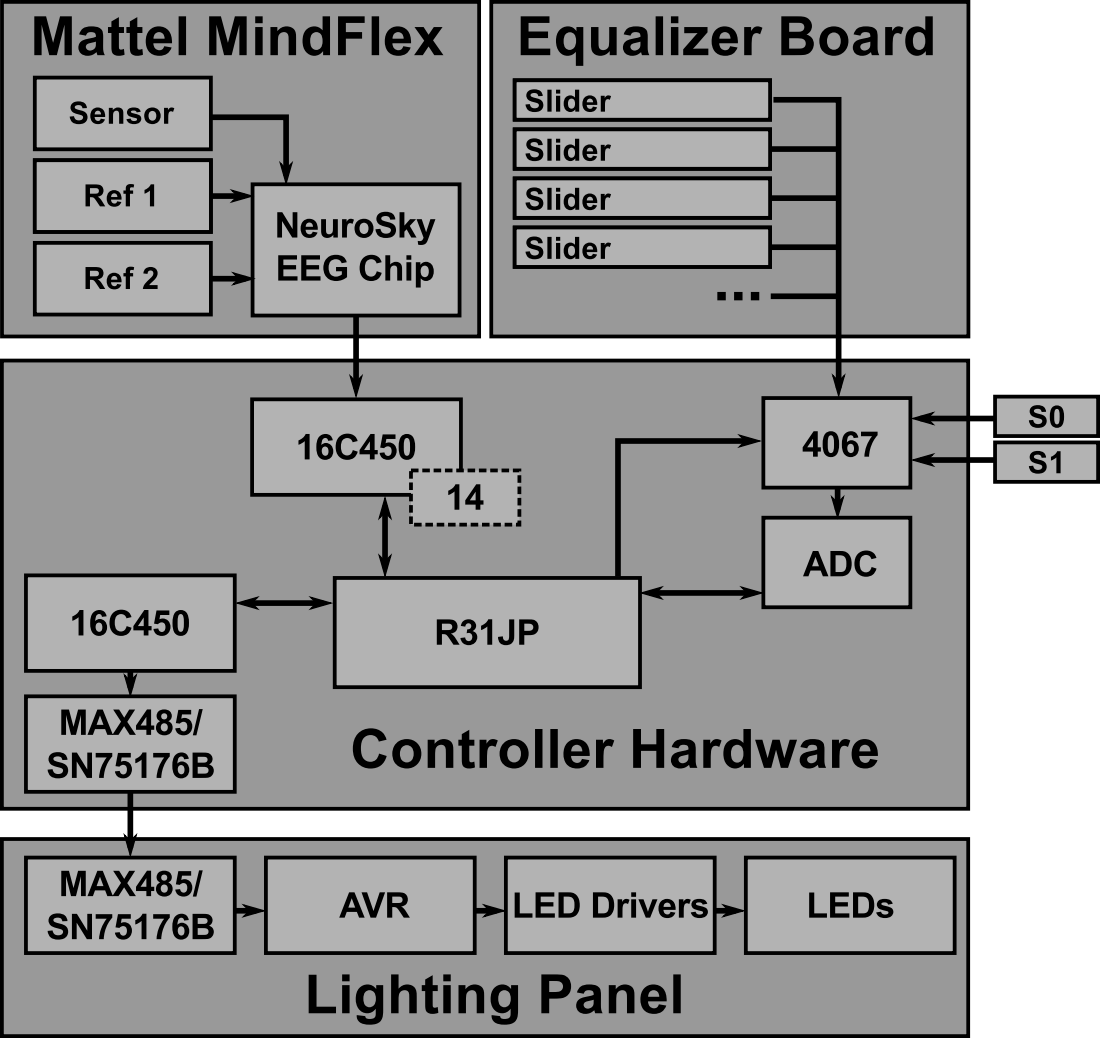
[picture p15: page 1]
