jwcxz/CEREBRO/report/fig/sm.pdf

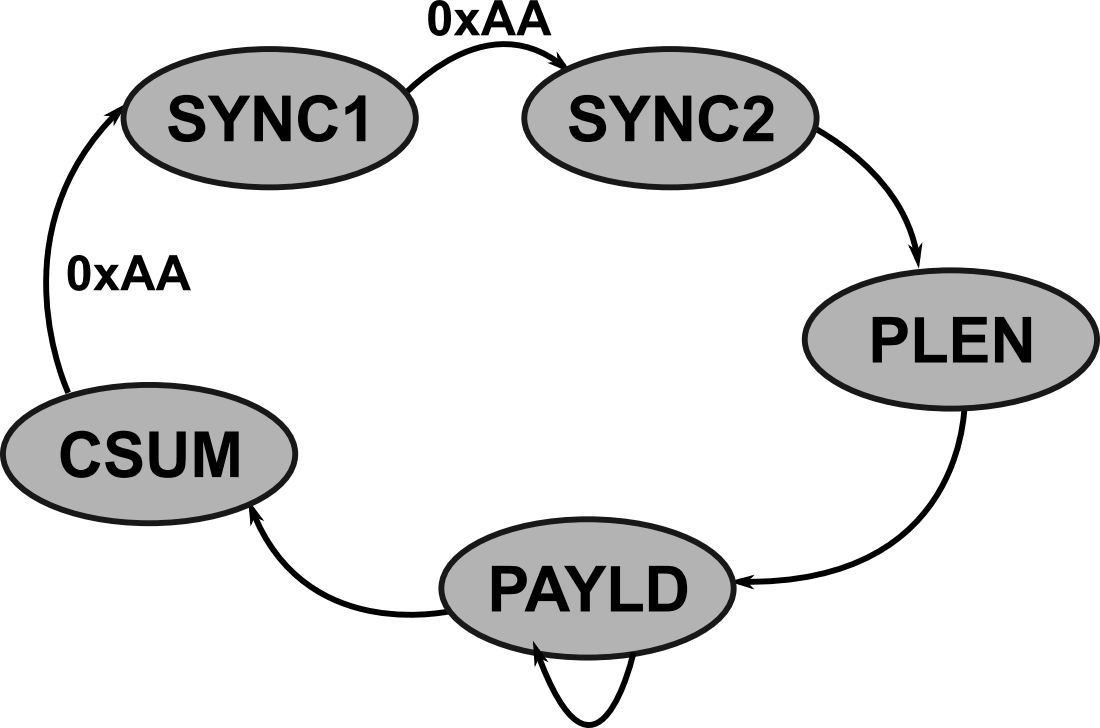
[picture p16: page 1]
