jwcxz/CEREBRO/report/fig/software.pdf

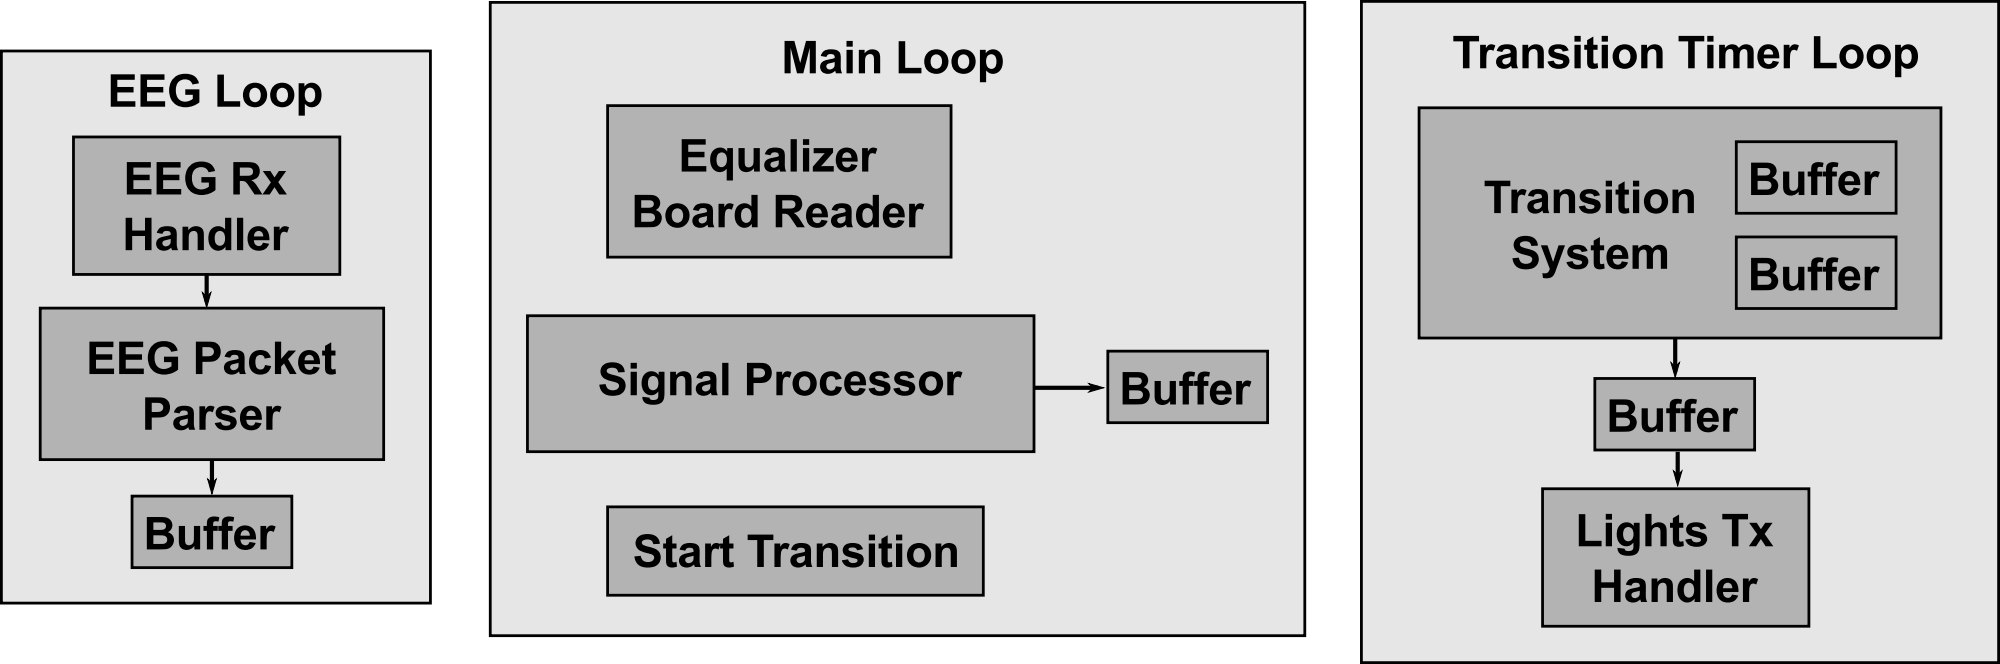
[picture p17: page 1]
