jwcxz/CEREBRO/layout/cerebro.pdf

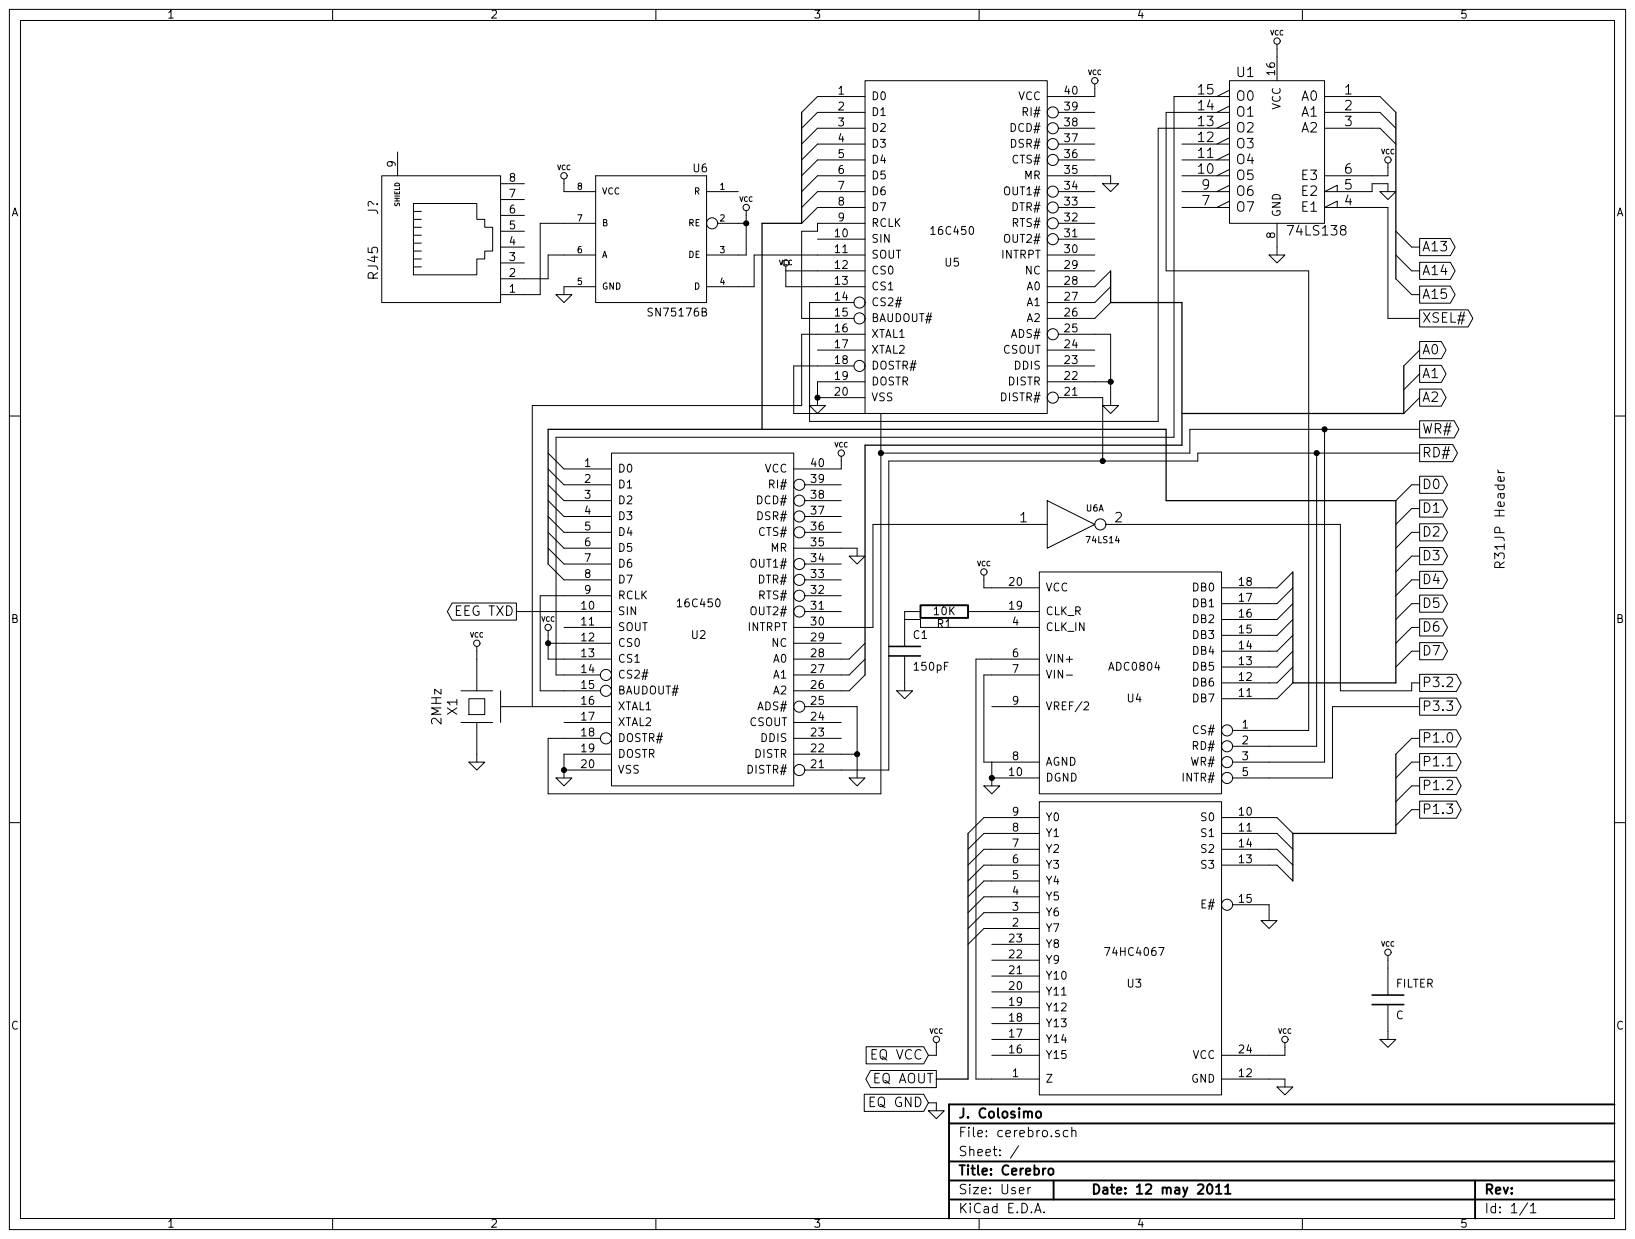
[picture p18: page 1]
