jwcxz/CEREBRO/layout/cerebro.sch

## KiCad design layout/cerebro.sch (2011-12-27)

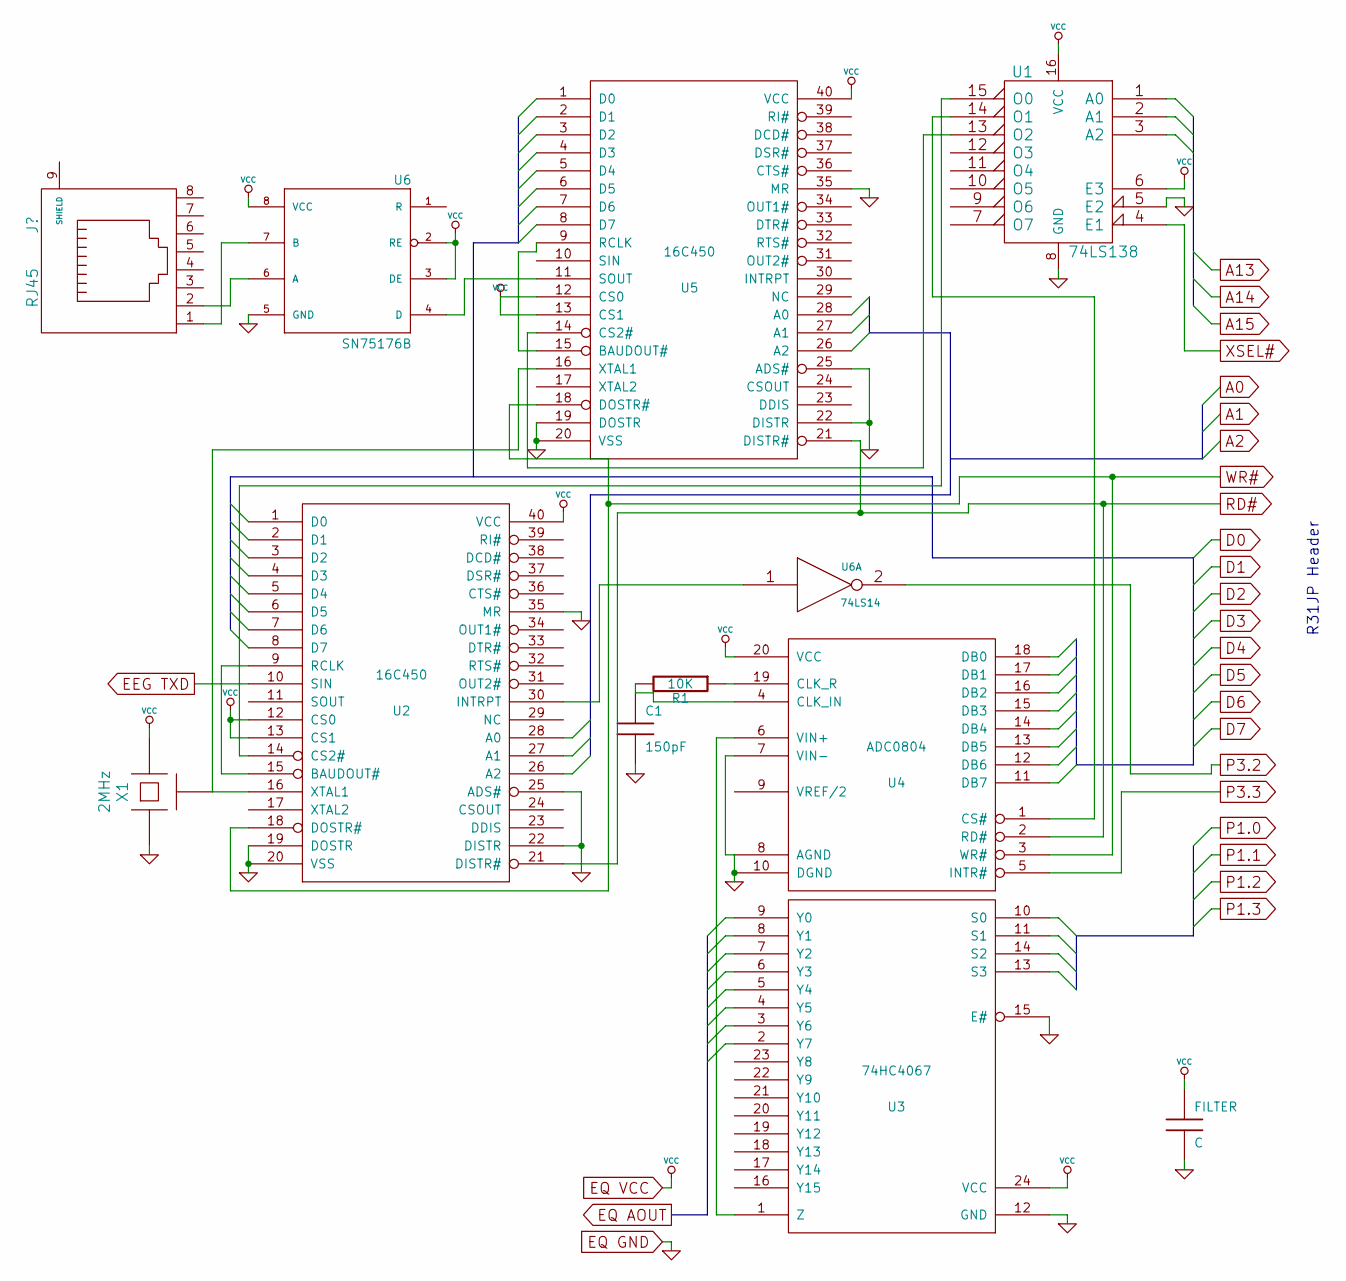
[picture p20: schematic cerebro.sch]

Parts:
C1: 150pF
FILTER: C
R1: 10K
U1: 74LS138
U2, U5: 16C450
U3: 74HC4067
U4: ADC0804
U6: 74LS14
X1: 2MHz

Connections:
EEG TXD: U2.10 (SIN)
EQ GND: C1.2, FILTER.2, U1.5 (E2), U1.8 (GND), U2.19 (DOSTR), U2.20 (VSS), U2.22 (DISTR), U2.25 (ADS#), U2.35 (MR), U3.12 (GND), U3.15 (E#), U4.7 (VIN-), U4.8 (AGND), U4.10 (DGND), U5.19 (DOSTR), U5.20 (VSS), U5.22 (DISTR), U5.25 (ADS#), U5.35 (MR), U6.5 (GND), X1.1
EQ VCC: FILTER.1, U1.6 (E3), U1.16 (VCC), U2.12 (CS0), U2.13 (CS1), U2.40 (VCC), U3.24 (VCC), U4.20 (VCC), U5.12 (CS0), U5.13 (CS1), U5.40 (VCC), U6.2 (RE), U6.3 (DE), U6.8 (VCC), X1.3
unnamed: C1.1, R1.2, U4.4 (CLK_IN)
unnamed: R1.1, U4.19 (CLK_R)
unnamed: U1.13 (O2), U5.14 (CS2#)
unnamed: U1.14 (O1), U4.1 (CS#)
unnamed: U1.15 (O0), U2.14 (CS2#)
unnamed: U2.9 (RCLK), U2.15 (BAUDOUT#)
unnamed: U2.16 (XTAL1), U5.16 (XTAL1), X1.2 (GND)
unnamed: U2.30 (INTRPT), U6.1 (R)
unnamed: U3.1 (Z), U4.6 (VIN+)
unnamed: U5.11 (SOUT), U6.4 (D)
unnamed: U5.9 (RCLK), U5.15 (BAUDOUT#)
P3.2: U6.2 (RE)
P3.3: U4.5 (INTR#)
RD#: U2.21 (DISTR#), U4.2 (RD#), U5.21 (DISTR#)
WR#: U2.18 (DOSTR#), U4.3 (WR#), U5.18 (DOSTR#)
XSEL#: U1.4 (E1)

Notes on the sheet:
R31JP Header
